rezasede/AURIX_MotorControl_TB_HW/KicadPower/MotorDrive_Power.csv

Reference | Value | Footprint
R10 | Res SMD | RESC1608X55N
R9 | Res SMD | RESC1608X55N
R8 | Res SMD | RESC1608X55N
R7 | Res SMD | RESC1608X55N
R6 | Res SMD | RESC1608X55N
R5 | Res SMD | RESC1608X55N
R4 | Res SMD | RESC1608X55N
R3 | Res SMD | RESC1608X55N
Q8 | IGB110S101 | IFX-PG-VSON-4-3-V
Q7 | IGB110S101 | IFX-PG-VSON-4-3-V
Q6 | IGB110S101 | IFX-PG-VSON-4-3-V
Q5 | IGB110S101 | IFX-PG-VSON-4-3-V
Q4 | IGB110S101 | IFX-PG-VSON-4-3-V
Q3 | IGB110S101 | IFX-PG-VSON-4-3-V
Q2 | IGB110S101 | IFX-PG-VSON-4-3-V
Q1 | IGB110S101 | IFX-PG-VSON-4-3-V
C56 | Cap SMD | CAPC3225X220N
C55 | Cap SMD | CAPC3225X220N
C54 | Cap SMD | CAPC3225X220N
C53 | Cap SMD | CAPC3225X220N
C52 | Cap SMD | CAPC3225X220N
C51 | Cap SMD | CAPC3225X220N
C50 | Cap SMD | CAPC3225X220N
C49 | Cap SMD | CAPC3225X220N
C48 | Cap SMD | CAPC3225X220N
C47 | Cap SMD | CAPC3216X100N
C46 | Cap SMD | CAPC3216X100N
C45 | Cap SMD | CAPC3216X100N
C44 | Cap SMD | CAPC3216X100N
C43 | Cap SMD | CAPC3216X100N
C42 | Cap SMD | CAPC3216X100N
C41 | Cap SMD | CAPC3216X100N
C40 | Cap SMD | CAPC3216X100N
C39 | Cap SMD | CAPC3216X100N
C38 | Cap SMD | CAPC3216X100N
C37 | Cap SMD | CAPC3216X100N
C36 | Cap SMD | CAPC3216X100N
C35 | Cap SMD | CAPC3216X100N
C34 | Cap SMD | CAPC3216X100N
C33 | Cap SMD | CAPC3225X220N
C32 | Cap SMD | CAPC3225X220N
C31 | Cap SMD | CAPC3225X220N
C30 | Cap SMD | CAPC3225X220N
C29 | Cap SMD | CAPC3225X220N
C28 | Cap SMD | CAPC3225X220N
C27 | Cap SMD | CAPC3225X220N
C26 | Cap SMD | CAPC3225X220N
C25 | Cap SMD | CAPC3225X220N
C24 | Cap SMD | CAPC3216X100N
C23 | Cap SMD | CAPC3216X100N
C22 | Cap SMD | CAPC3216X100N
C21 | Cap SMD | CAPC3216X100N
C20 | Cap SMD | CAPC3216X100N
C19 | Cap SMD | CAPC3216X100N
C18 | Cap SMD | CAPC3216X100N
C17 | Cap SMD | CAPC3216X100N
C16 | Cap SMD | CAPC3216X100N
C15 | Cap SMD | CAPC3216X100N
C14 | Cap SMD | CAPC3216X100N
C13 | Cap SMD | CAPC3216X100N
C12 | Cap SMD | CAPC3216X100N
C11 | Cap SMD | CAPC3216X100N
C10 | Cap Pol | CAP-6.3-7.7
C9 | Cap Pol | CAP-6.3-7.7
C8 | Cap SMD | CAPC1608X90N
C7 | Cap SMD | CAPC1608X90N
C6 | Cap SMD | CAPC1608X90N
C5 | Cap SMD | CAPC1608X90N
C4 | Cap SMD | CAPC1608X90N
C3 | Cap SMD | CAPC1608X90N
C2 | Cap SMD | CAPC1608X90N
C1 | Cap SMD | CAPC1608X90N
