rezasede/AURIX_MotorControl_TB_HW/KicadPower/MotorDrive_Power.kicad_pcb

## KiCad design KicadPower/MotorDrive_Power.kicad_pcb (2026-10-25)

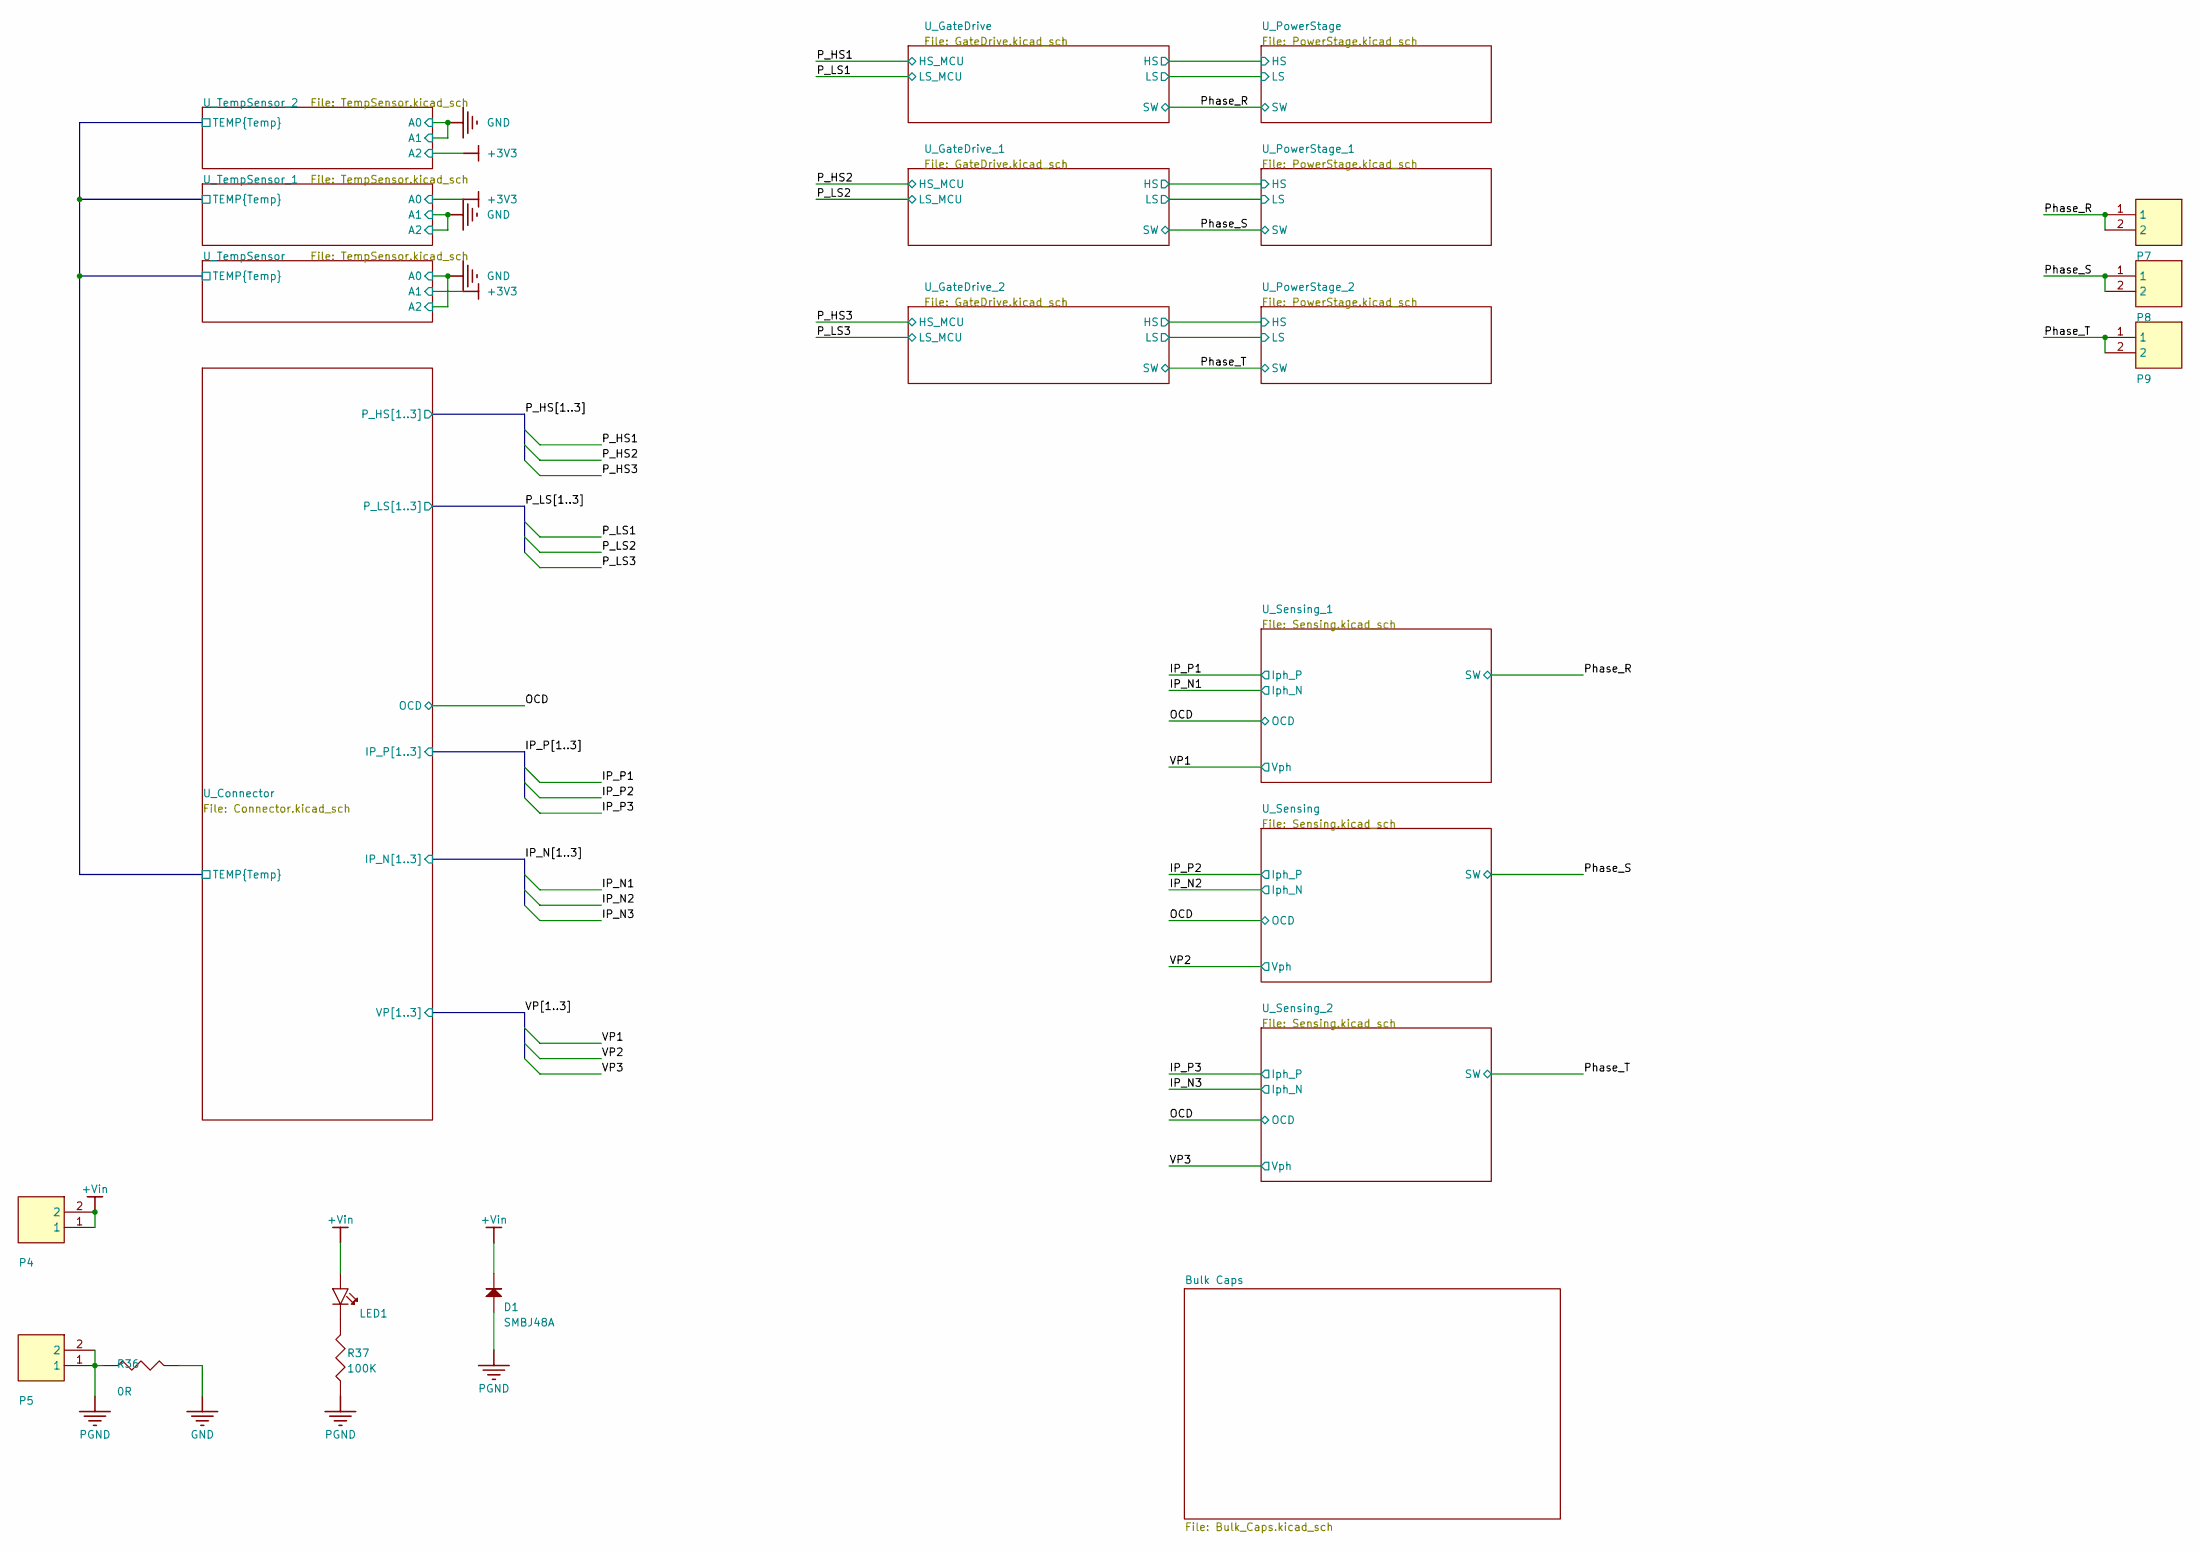
[picture p1: schematic MotorDrive_Power.kicad_sch]

Parts:
D1: SMBJ48A; DO-214AA
LED1: LED; LED0603
P4, P5, P7, P8, P9: Connector; Terminal Block 2pin
R36: Res SMD; RESC3225X70N
R37: Res SMD; RESC1608X55N

Connections:
+Vin: D1.K (2), LED1.1 (A), P4.1, P4.2; also elsewhere on the board
/Phase_R: P7.1, P7.2; also elsewhere on the board
/Phase_S: P8.1, P8.2; also elsewhere on the board
/Phase_T: P9.1, P9.2; also elsewhere on the board
GND: R36.2; also elsewhere on the board
unnamed: LED1.2 (K), R37.2
PGND: D1.A (1), P5.1, P5.2, R36.1, R37.1; also elsewhere on the board

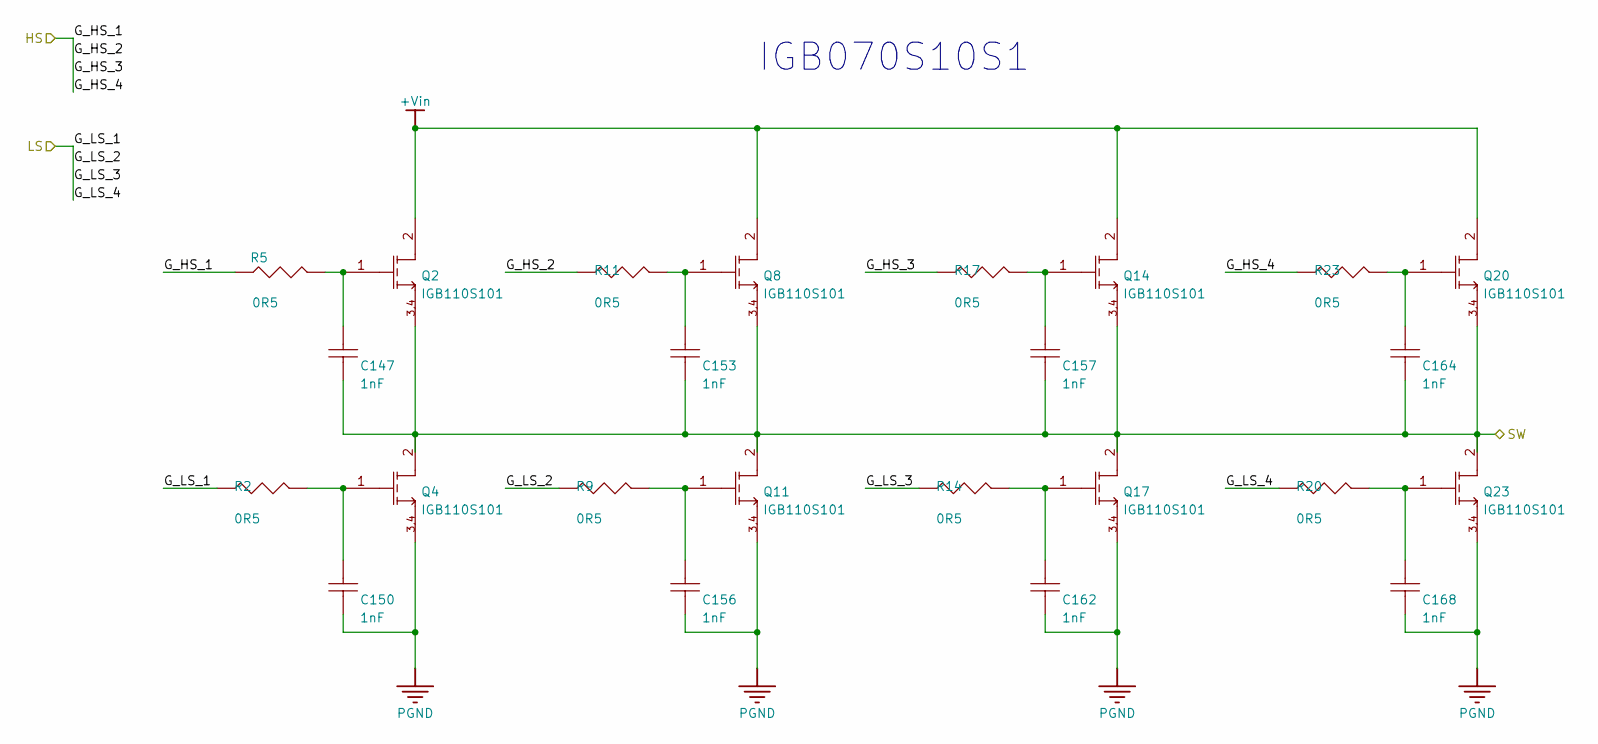
[picture p2: schematic PowerStage.kicad_sch]

Parts:
C147, C150, C153, C156, C157, C162, C164, C168: Cap SMD; CAPC1608X90N
Q2, Q4, Q8, Q11, Q14, Q17, Q20, Q23: IGB110S101; IFX-PG-VSON-4-3-V
R2, R5, R9, R11, R14, R17, R20, R23: Res SMD; RESC1608X55N

Connections:
+Vin: Q2.2 (D), Q8.2 (D), Q14.2 (D), Q20.2 (D); also elsewhere on the board
/Phase_R: C147.1, C153.1, C157.1, C164.1, Q2.3 (S1), Q2.4 (S2), Q4.2 (D), Q8.3 (S1), Q8.4 (S2), Q11.2 (D), Q14.3 (S1), Q14.4 (S2), Q17.2 (D), Q20.3 (S1), Q20.4 (S2), Q23.2 (D); also elsewhere on the board
/U_PowerStage/G_HS_1: R5.1, R11.1, R17.1, R23.1; also elsewhere on the board
/U_PowerStage/G_LS_1: R2.1, R9.1, R14.1, R20.1; also elsewhere on the board
unnamed: C147.2, Q2.1 (G), R5.2
unnamed: C150.2, Q4.1 (G), R2.2
unnamed: C153.2, Q8.1 (G), R11.2
unnamed: C156.2, Q11.1 (G), R9.2
unnamed: C157.2, Q14.1 (G), R17.2
unnamed: C162.2, Q17.1 (G), R14.2
unnamed: C164.2, Q20.1 (G), R23.2
unnamed: C168.2, Q23.1 (G), R20.2
PGND: C150.1, C156.1, C162.1, C168.1, Q4.3 (S1), Q4.4 (S2), Q11.3 (S1), Q11.4 (S2), Q17.3 (S1), Q17.4 (S2), Q23.3 (S1), Q23.4 (S2); also elsewhere on the board

Parts of its further copies:
C145, C146, C148, C149, C151, C152, C154, C155, C158, C159, C160, C161, C163, C165, C166, C167: Cap SMD; CAPC1608X90N
Q1, Q3, Q5, Q6, Q7, Q9, Q10, Q12, Q13, Q15, Q16, Q18, Q19, Q21, Q22, Q24: IGB110S101; IFX-PG-VSON-4-3-V
R1, R3, R4, R6, R7, R8, R10, R12, R13, R15, R16, R18, R19, R21, R22, R24: Res SMD; RESC1608X55N

Connections of its further copies:
+Vin: Q1.2 (D), Q3.2 (D), Q7.2 (D), Q9.2 (D), Q13.2 (D), Q15.2 (D), Q19.2 (D), Q21.2 (D); also elsewhere on the board
/Phase_S: C145.1, C152.1, C159.1, C163.1, Q1.3 (S1), Q1.4 (S2), Q5.2 (D), Q7.3 (S1), Q7.4 (S2), Q10.2 (D), Q13.3 (S1), Q13.4 (S2), Q18.2 (D), Q21.3 (S1), Q21.4 (S2), Q24.2 (D); also elsewhere on the board
/Phase_T: C146.1, C151.1, C158.1, C165.1, Q3.3 (S1), Q3.4 (S2), Q6.2 (D), Q9.3 (S1), Q9.4 (S2), Q12.2 (D), Q15.3 (S1), Q15.4 (S2), Q16.2 (D), Q19.3 (S1), Q19.4 (S2), Q22.2 (D); also elsewhere on the board
/U_PowerStage_1/G_HS_1: R4.1, R10.1, R18.1, R22.1; also elsewhere on the board
/U_PowerStage_1/G_LS_1: R1.1, R7.1, R15.1, R19.1; also elsewhere on the board
/U_PowerStage_2/G_HS_1: R6.1, R12.1, R16.1, R24.1; also elsewhere on the board
/U_PowerStage_2/G_LS_1: R3.1, R8.1, R13.1, R21.1; also elsewhere on the board
unnamed: C145.2, Q1.1 (G), R4.2
unnamed: C146.2, Q3.1 (G), R6.2
unnamed: C149.2, Q5.1 (G), R1.2
unnamed: C148.2, Q6.1 (G), R3.2
unnamed: C152.2, Q7.1 (G), R10.2
unnamed: C151.2, Q9.1 (G), R12.2
unnamed: C155.2, Q10.1 (G), R7.2
unnamed: C154.2, Q12.1 (G), R8.2
unnamed: C159.2, Q13.1 (G), R18.2
unnamed: C158.2, Q15.1 (G), R16.2
unnamed: C161.2, Q16.1 (G), R13.2
unnamed: C160.2, Q18.1 (G), R15.2
unnamed: C165.2, Q19.1 (G), R24.2
unnamed: C163.2, Q21.1 (G), R22.2
unnamed: C167.2, Q22.1 (G), R21.2
unnamed: C166.2, Q24.1 (G), R19.2
PGND: C148.1, C149.1, C154.1, C155.1, C160.1, C161.1, C166.1, C167.1, Q5.3 (S1), Q5.4 (S2), Q6.3 (S1), Q6.4 (S2), Q10.3 (S1), Q10.4 (S2), Q12.3 (S1), Q12.4 (S2), Q16.3 (S1), Q16.4 (S2), Q18.3 (S1), Q18.4 (S2), Q22.3 (S1), Q22.4 (S2), Q24.3 (S1), Q24.4 (S2); also elsewhere on the board

Notes on the sheet:
IGB070S10S1

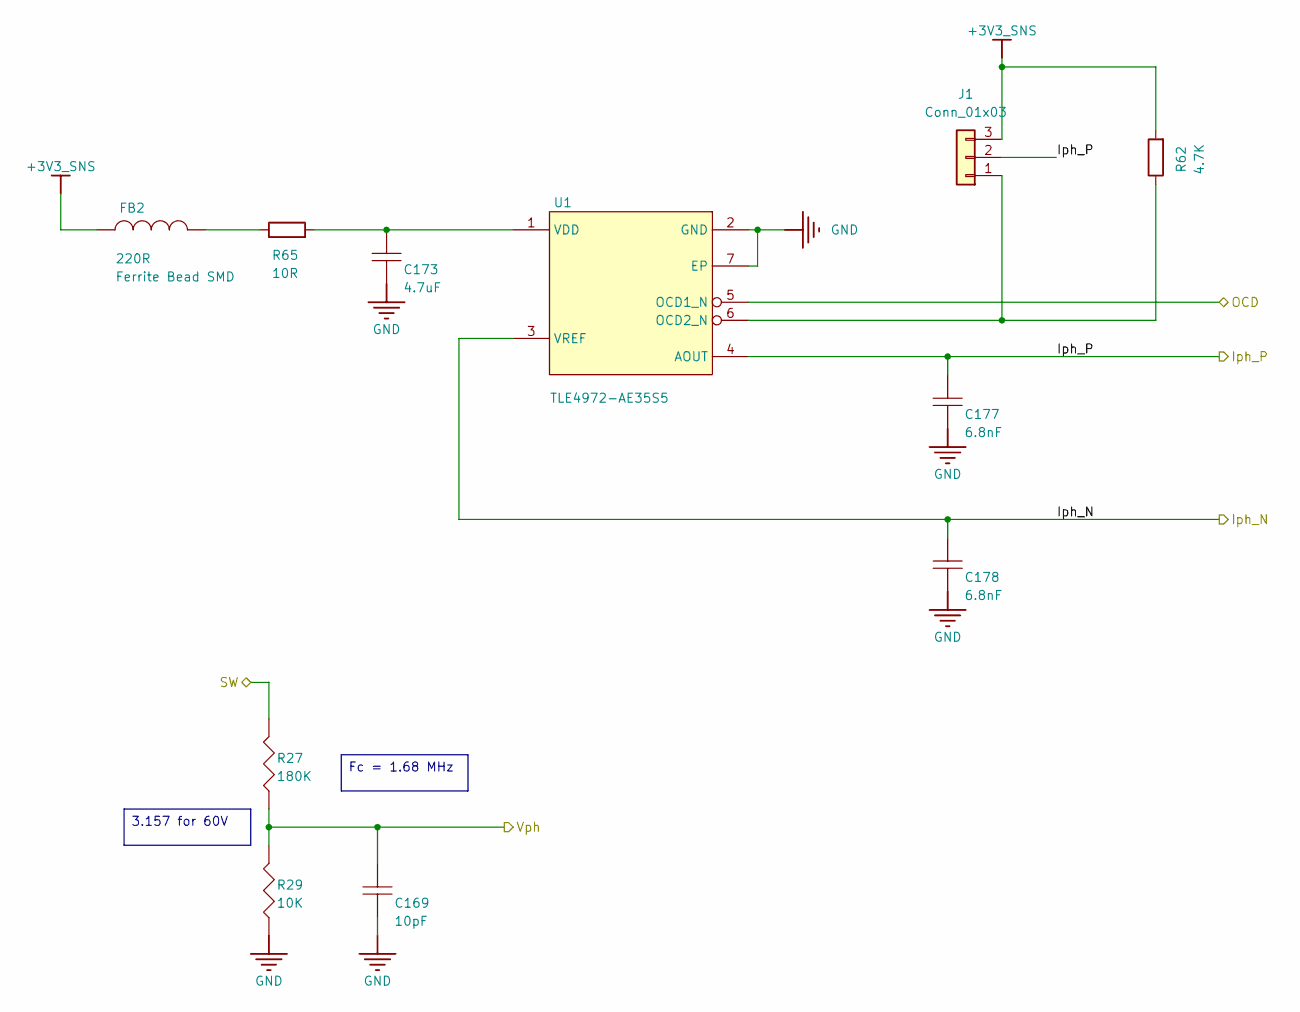
[picture p3: schematic Sensing.kicad_sch]

Parts:
C169, C177, C178: Cap SMD; CAPC1608X90N
C173: Cap SMD; CAPC2012X135N
FB2: Ferrite Bead SMD; RESC2012X70N
J1: Conn_01x03; PinHeader_1x03_P2.54mm_Vertical
R27, R29: Res SMD; RESC1608X55N
R62: 4.7K; R_0603_1608Metric_Pad0.98x0.95mm_HandSolder
R65: 10R; R_0603_1608Metric_Pad0.98x0.95mm_HandSolder
U1: TLE4972-AE35S5; IFX-PG-VSON-6-V

Connections:
+3V3_SNS: FB2.1, J1.3, R62.2; also elsewhere on the board
/IP_N1: C178.2, U1.3 (VREF); also elsewhere on the board
/IP_P1: C177.2, J1.2, U1.4 (AOUT); also elsewhere on the board
/OCD: U1.5 (OCD1_N); also elsewhere on the board
/Phase_R: R27.2; also elsewhere on the board
/VP1: C169.2, R27.1, R29.2; also elsewhere on the board
GND: C169.1, C173.1, C177.1, C178.1, R29.1, U1.2 (GND), U1.7 (EP); also elsewhere on the board
unnamed: FB2.2, R65.1
unnamed: J1.1, R62.1, U1.6 (OCD2_N)
unnamed: C173.2, R65.2, U1.1 (VDD)

Parts of its further copies:
C170, C171, C175, C176, C179, C180: Cap SMD; CAPC1608X90N
C172, C174: Cap SMD; CAPC2012X135N
FB1, FB3: Ferrite Bead SMD; RESC2012X70N
J2, J3: Conn_01x03; PinHeader_1x03_P2.54mm_Vertical
R25, R26, R28, R30: Res SMD; RESC1608X55N
R63, R64: 4.7K; R_0603_1608Metric_Pad0.98x0.95mm_HandSolder
R66, R67: 10R; R_0603_1608Metric_Pad0.98x0.95mm_HandSolder
U2, U3: TLE4972-AE35S5; IFX-PG-VSON-6-V

Connections of its further copies:
+3V3_SNS: FB1.1, FB3.1, J2.3, J3.3, R63.2, R64.2; also elsewhere on the board
/IP_N2: C179.2, U2.3 (VREF); also elsewhere on the board
/IP_N3: C180.2, U3.3 (VREF); also elsewhere on the board
/IP_P2: C176.2, J2.2, U2.4 (AOUT); also elsewhere on the board
/IP_P3: C175.2, J3.2, U3.4 (AOUT); also elsewhere on the board
/OCD: U2.5 (OCD1_N), U3.5 (OCD1_N); also elsewhere on the board
/Phase_S: R25.2; also elsewhere on the board
/Phase_T: R26.2; also elsewhere on the board
/VP2: C170.2, R25.1, R30.2; also elsewhere on the board
/VP3: C171.2, R26.1, R28.2; also elsewhere on the board
GND: C170.1, C171.1, C172.1, C174.1, C175.1, C176.1, C179.1, C180.1, R28.1, R30.1, U2.2 (GND), U2.7 (EP), U3.2 (GND), U3.7 (EP); also elsewhere on the board
unnamed: FB1.2, R67.1
unnamed: FB3.2, R66.1
unnamed: J2.1, R63.1, U2.6 (OCD2_N)
unnamed: J3.1, R64.1, U3.6 (OCD2_N)
unnamed: C174.2, R66.2, U2.1 (VDD)
unnamed: C172.2, R67.2, U3.1 (VDD)

Notes on the sheet:
Fc = 1.68 MHz
3.157 for 60V

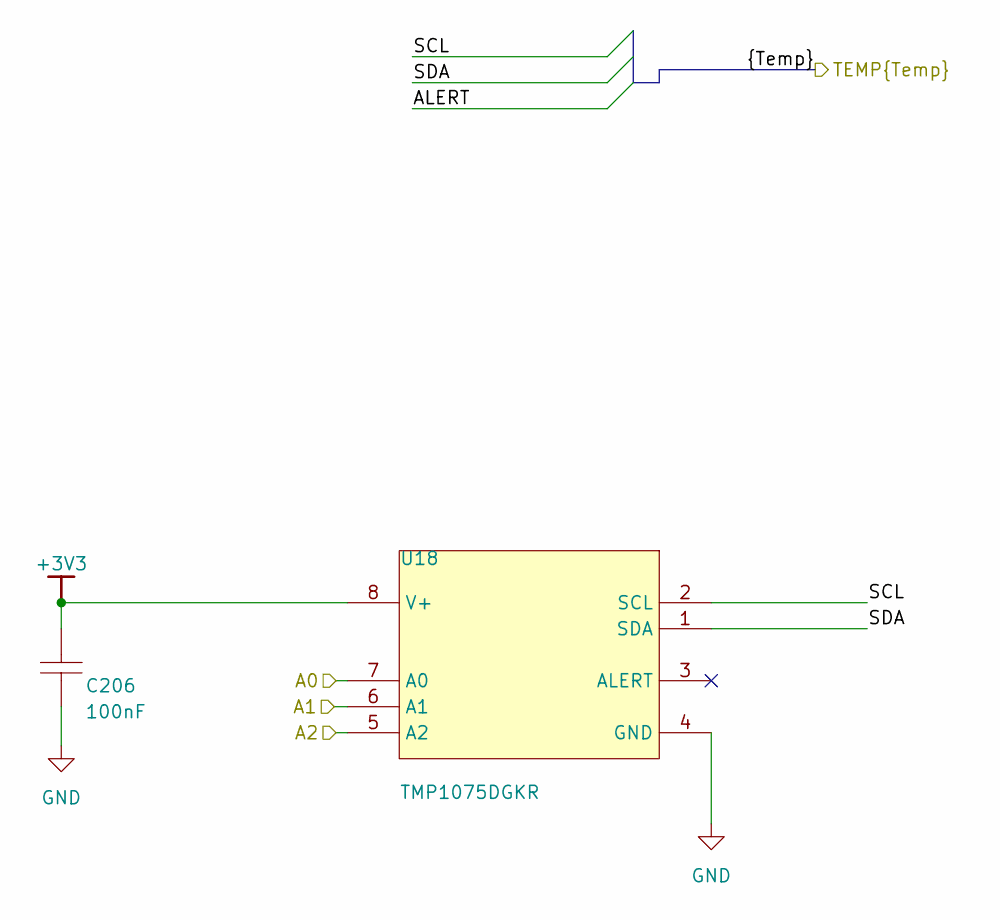
[picture p4: schematic TempSensor.kicad_sch]

Parts:
C206: Cap SMD; CAPC1608X90N
U18: TMP1075DGKR; DGK0008A_N; MANUFACTURER_PART_NUMBER TMP1075DGKR

Connections:
+3V3: C206.2, U18.5 (A2), U18.8 (V+); also elsewhere on the board
/U_Connector/SCL: U18.2 (SCL); also elsewhere on the board
/U_Connector/SDA: U18.1 (SDA); also elsewhere on the board
GND: C206.1, U18.4 (GND), U18.6 (A1), U18.7 (A0); also elsewhere on the board

Parts of its further copies:
C207, C208: Cap SMD; CAPC1608X90N
U17, U19: TMP1075DGKR; DGK0008A_N; MANUFACTURER_PART_NUMBER TMP1075DGKR

Connections of its further copies:
+3V3: C207.2, C208.2, U17.7 (A0), U17.8 (V+), U19.6 (A1), U19.8 (V+); also elsewhere on the board
/U_Connector/SCL: U17.2 (SCL), U19.2 (SCL); also elsewhere on the board
/U_Connector/SDA: U17.1 (SDA), U19.1 (SDA); also elsewhere on the board
GND: C207.1, C208.1, U17.4 (GND), U17.5 (A2), U17.6 (A1), U19.4 (GND), U19.5 (A2), U19.7 (A0); also elsewhere on the board

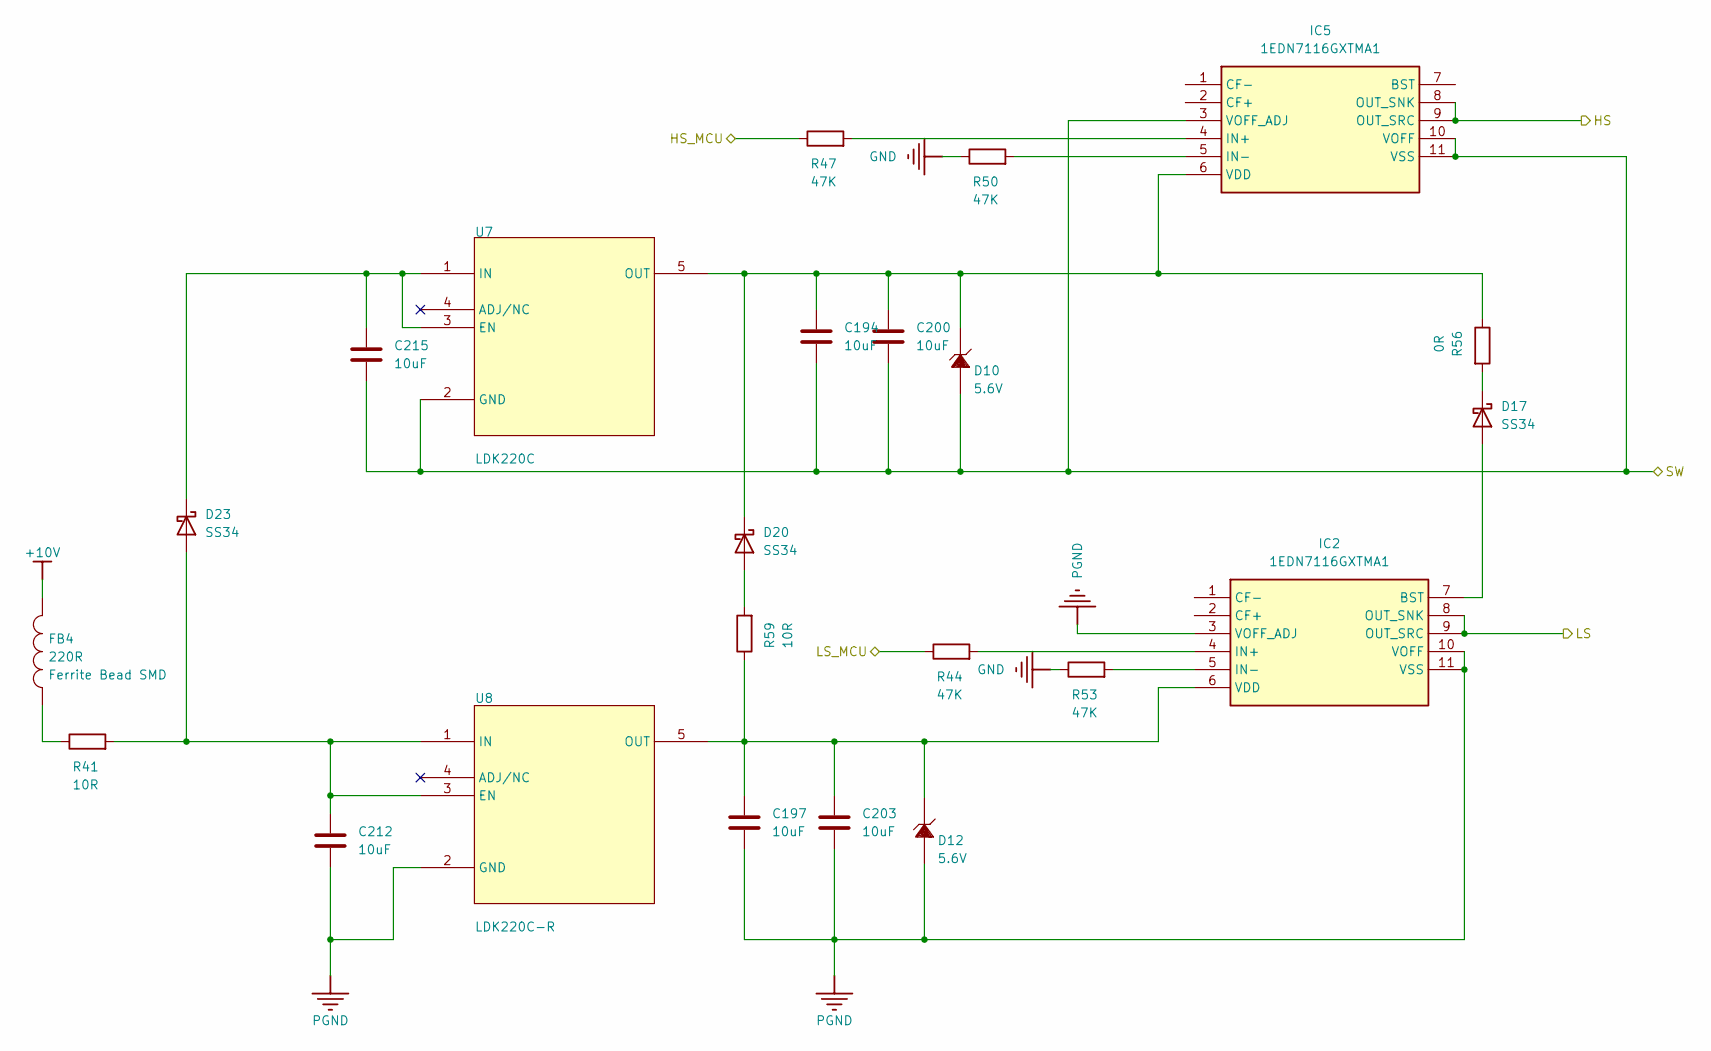
[picture p5: schematic GateDrive.kicad_sch]

Parts:
C194, C197, C200, C203, C212, C215: 10uF; C_0603_1608Metric
D10, D12: 5.6V; DIOMELF3615N
D17, D20, D23: SS34; D_SMA
FB4: Ferrite Bead SMD; RESC2012X70N
IC2, IC5: 1EDN7116GXTMA1; Manufacturer_Part_Number 1EDN7116GXTMA1; Mouser Part Number 726-1EDN7116GXTMA1
R41, R59: 10R; R_0603_1608Metric_Pad0.98x0.95mm_HandSolder
R44, R47, R50, R53: 47K; R_0603_1608Metric_Pad0.98x0.95mm_HandSolder
R56: 0R; R_0603_1608Metric_Pad0.98x0.95mm_HandSolder
U7: LDK220C; SOT_220M-R_STM; MANUFACTURER_PART_NUMBER LDK220C-R
U8: LDK220C-R; SOT_220M-R_STM; MANUFACTURER_PART_NUMBER LDK220C-R

Connections:
+10V: FB4.2; also elsewhere on the board
/P_HS1: R47.1; also elsewhere on the board
/P_LS1: R44.1; also elsewhere on the board
/Phase_R: C194.2, C200.2, C215.2, D10.2, IC5.3 (VOFF_ADJ), IC5.10 (VOFF), IC5.11 (VSS), U7.2 (GND); also elsewhere on the board
/U_PowerStage/G_HS_1: IC5.8 (OUT_SNK), IC5.9 (OUT_SRC); also elsewhere on the board
/U_PowerStage/G_LS_1: IC2.8 (OUT_SNK), IC2.9 (OUT_SRC); also elsewhere on the board
GND: R50.1, R53.1; also elsewhere on the board
unnamed: D17.2 (A), IC2.7 (BST)
unnamed: D17.1 (K), R56.2
unnamed: D20.2 (A), R59.2
unnamed: C194.1, C200.1, D10.1, D20.1 (K), IC5.6 (VDD), R56.1, U7.5 (OUT)
unnamed: C212.1, D23.2 (A), R41.2, U8.1 (IN), U8.3 (EN)
unnamed: C215.1, D23.1 (K), U7.1 (IN), U7.3 (EN)
unnamed: FB4.1, R41.1
unnamed: IC2.4 (IN+), R44.2
unnamed: IC2.5 (IN-), R53.2
unnamed: C197.1, C203.1, D12.1, IC2.6 (VDD), R59.1, U8.5 (OUT)
unnamed: IC5.4 (IN+), R47.2
unnamed: IC5.5 (IN-), R50.2
PGND: C197.2, C203.2, C212.2, D12.2, IC2.3 (VOFF_ADJ), IC2.10 (VOFF), IC2.11 (VSS), U8.2 (GND); also elsewhere on the board

Parts of its further copies:
C195, C196, C198, C199, C201, C202, C204, C205, C213, C214, C216, C217: 10uF; C_0603_1608Metric
D8, D9, D11, D13: 5.6V; DIOMELF3615N
D18, D19, D21, D22, D24, D25: SS34; D_SMA
FB5, FB6: Ferrite Bead SMD; RESC2012X70N
IC3, IC4, IC6, IC7: 1EDN7116GXTMA1; Manufacturer_Part_Number 1EDN7116GXTMA1; Mouser Part Number 726-1EDN7116GXTMA1
R42, R43, R60, R61: 10R; R_0603_1608Metric_Pad0.98x0.95mm_HandSolder
R45, R46, R48, R49, R51, R52, R54, R55: 47K; R_0603_1608Metric_Pad0.98x0.95mm_HandSolder
R57, R58: 0R; R_0603_1608Metric_Pad0.98x0.95mm_HandSolder
U5, U6: LDK220C; SOT_220M-R_STM; MANUFACTURER_PART_NUMBER LDK220C-R
U9, U10: LDK220C-R; SOT_220M-R_STM; MANUFACTURER_PART_NUMBER LDK220C-R

Connections of its further copies:
+10V: FB5.2, FB6.2; also elsewhere on the board
/P_HS2: R48.1; also elsewhere on the board
/P_HS3: R49.1; also elsewhere on the board
/P_LS2: R45.1; also elsewhere on the board
/P_LS3: R46.1; also elsewhere on the board
/Phase_S: C195.2, C201.2, C216.2, D9.2, IC6.3 (VOFF_ADJ), IC6.10 (VOFF), IC6.11 (VSS), U6.2 (GND); also elsewhere on the board
/Phase_T: C196.2, C202.2, C217.2, D8.2, IC7.3 (VOFF_ADJ), IC7.10 (VOFF), IC7.11 (VSS), U5.2 (GND); also elsewhere on the board
/U_PowerStage_1/G_HS_1: IC6.8 (OUT_SNK), IC6.9 (OUT_SRC); also elsewhere on the board
/U_PowerStage_1/G_LS_1: IC3.8 (OUT_SNK), IC3.9 (OUT_SRC); also elsewhere on the board
/U_PowerStage_2/G_HS_1: IC7.8 (OUT_SNK), IC7.9 (OUT_SRC); also elsewhere on the board
/U_PowerStage_2/G_LS_1: IC4.8 (OUT_SNK), IC4.9 (OUT_SRC); also elsewhere on the board
GND: R51.1, R52.1, R54.1, R55.1; also elsewhere on the board
unnamed: D18.2 (A), IC3.7 (BST)
unnamed: D18.1 (K), R57.2
unnamed: D19.2 (A), IC4.7 (BST)
unnamed: D19.1 (K), R58.2
unnamed: D21.2 (A), R60.2
unnamed: C195.1, C201.1, D9.1, D21.1 (K), IC6.6 (VDD), R57.1, U6.5 (OUT)
unnamed: D22.2 (A), R61.2
unnamed: C196.1, C202.1, D8.1, D22.1 (K), IC7.6 (VDD), R58.1, U5.5 (OUT)
unnamed: C213.1, D24.2 (A), R42.2, U10.1 (IN), U10.3 (EN)
unnamed: C216.1, D24.1 (K), U6.1 (IN), U6.3 (EN)
unnamed: C214.1, D25.2 (A), R43.2, U9.1 (IN), U9.3 (EN)
unnamed: C217.1, D25.1 (K), U5.1 (IN), U5.3 (EN)
unnamed: FB5.1, R43.1
unnamed: FB6.1, R42.1
unnamed: IC3.4 (IN+), R45.2
unnamed: IC3.5 (IN-), R54.2
unnamed: C198.1, C204.1, D13.1, IC3.6 (VDD), R60.1, U10.5 (OUT)
unnamed: IC4.4 (IN+), R46.2
unnamed: IC4.5 (IN-), R55.2
unnamed: C199.1, C205.1, D11.1, IC4.6 (VDD), R61.1, U9.5 (OUT)
unnamed: IC6.4 (IN+), R48.2
unnamed: IC6.5 (IN-), R51.2
unnamed: IC7.4 (IN+), R49.2
unnamed: IC7.5 (IN-), R52.2
PGND: C198.2, C199.2, C204.2, C205.2, C213.2, C214.2, D11.2, D13.2, IC3.3 (VOFF_ADJ), IC3.10 (VOFF), IC3.11 (VSS), IC4.3 (VOFF_ADJ), IC4.10 (VOFF), IC4.11 (VSS), U9.2 (GND), U10.2 (GND); also elsewhere on the board

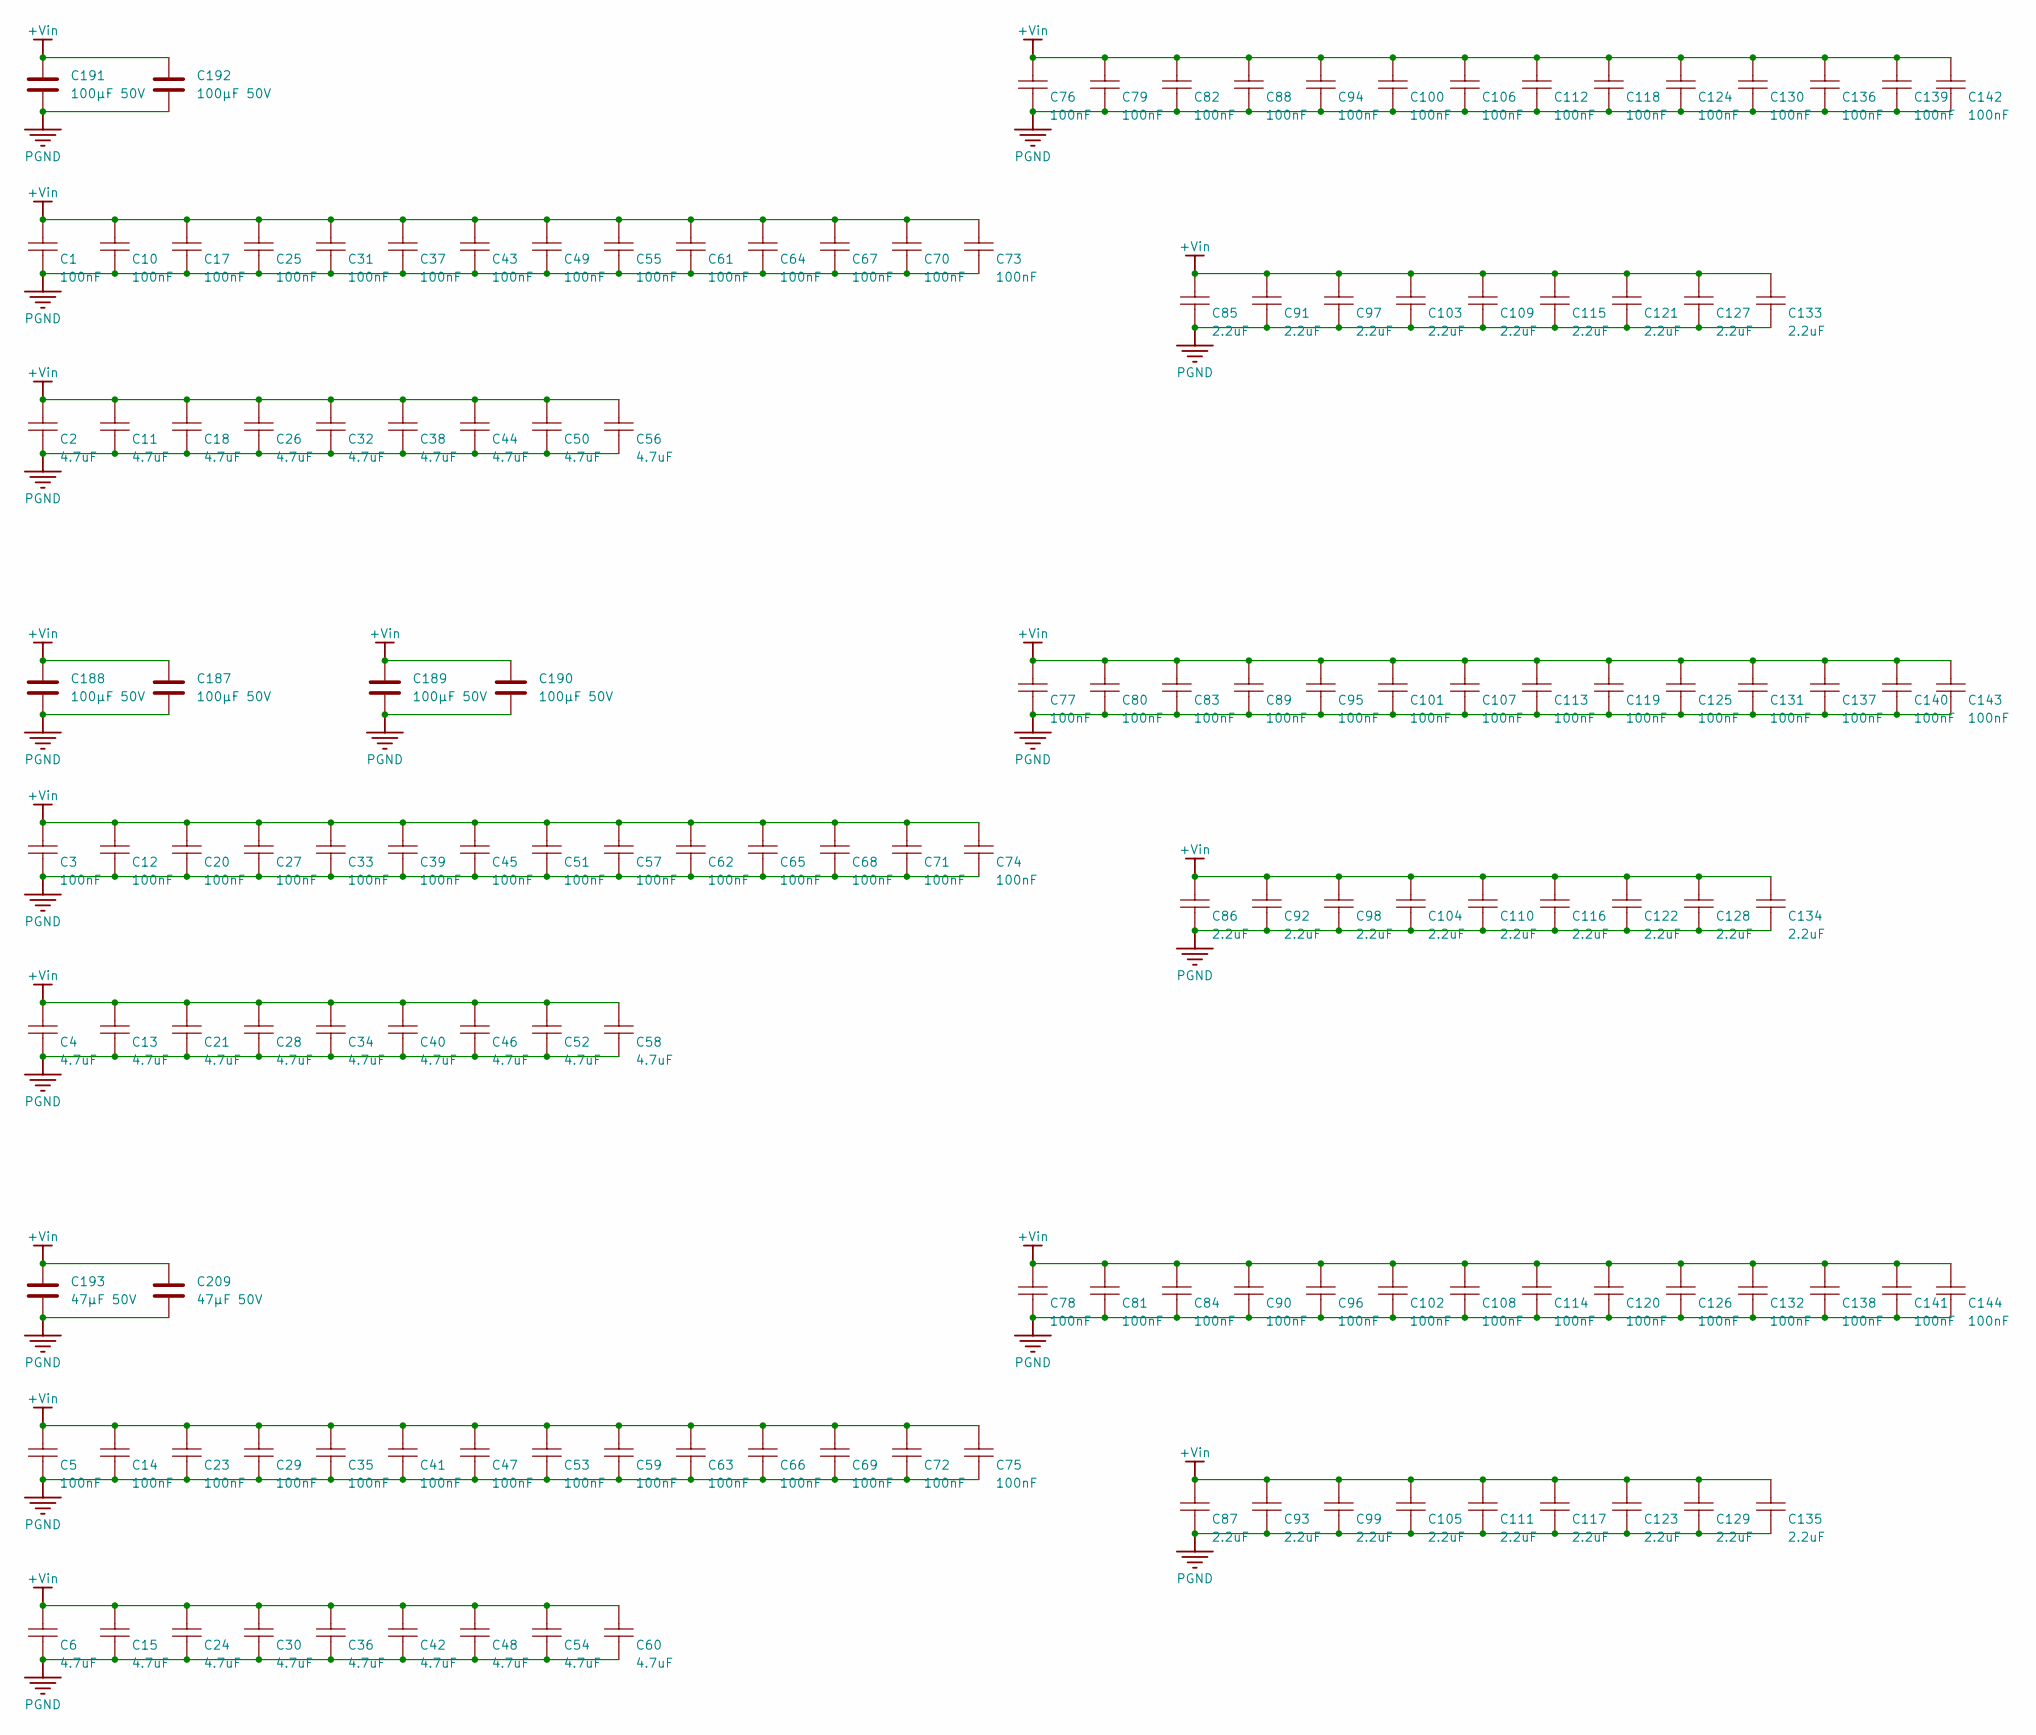
[picture p6: schematic Bulk_Caps.kicad_sch]

Parts:
C1, C3, C5, C10, C12, C14, C17, C20, C23, C25, C27, C29, C31, C33, C35, C37, C39, C41, C43, C45, C47, C49, C51, C53, C55, C57, C59, C61, C62, C63, C64, C65, C66, C67, C68, C69, C70, C71, C72, C73, C74, C75, C76, C77, C78, C79, C80, C81, C82, C83, C84, C88, C89, C90, C94, C95, C96, C100, C101, C102, C106, C107, C108, C112, C113, C114, C118, C119, C120, C124, C125, C126, C130, C131, C132, C136, C137, C138, C139, C140, C141, C142, C143, C144: Cap SMD; CAPC3216X100N
C2, C4, C6, C11, C13, C15, C18, C21, C24, C26, C28, C30, C32, C34, C36, C38, C40, C42, C44, C46, C48, C50, C52, C54, C56, C58, C60, C85, C86, C87, C91, C92, C93, C97, C98, C99, C103, C104, C105, C109, C110, C111, C115, C116, C117, C121, C122, C123, C127, C128, C129, C133, C134, C135: Cap SMD; CAPC3225X220N
C187, C188, C189, C190, C191, C192: 100µF 50V; C_Elec_8x10.2
C193, C209: 47µF 50V; C_Elec_6.3x7.7

Connections:
+Vin: C1.2, C2.2, C3.2, C4.2, C5.2, C6.2, C10.2, C11.2, C12.2, C13.2, C14.2, C15.2, C17.2, C18.2, C20.2, C21.2, C23.2, C24.2, C25.2, C26.2, C27.2, C28.2, C29.2, C30.2, C31.2, C32.2, C33.2, C34.2, C35.2, C36.2, C37.2, C38.2, C39.2, C40.2, C41.2, C42.2, C43.2, C44.2, C45.2, C46.2, C47.2, C48.2, C49.2, C50.2, C51.2, C52.2, C53.2, C54.2, C55.2, C56.2, C57.2, C58.2, C59.2, C60.2, C61.2, C62.2, C63.2, C64.2, C65.2, C66.2, C67.2, C68.2, C69.2, C70.2, C71.2, C72.2, C73.2, C74.2, C75.2, C76.2, C77.2, C78.2, C79.2, C80.2, C81.2, C82.2, C83.2, C84.2, C85.2, C86.2, C87.2, C88.2, C89.2, C90.2, C91.2, C92.2, C93.2, C94.2, C95.2, C96.2, C97.2, C98.2, C99.2, C100.2, C101.2, C102.2, C103.2, C104.2, C105.2, C106.2, C107.2, C108.2, C109.2, C110.2, C111.2, C112.2, C113.2, C114.2, C115.2, C116.2, C117.2, C118.2, C119.2, C120.2, C121.2, C122.2, C123.2, C124.2, C125.2, C126.2, C127.2, C128.2, C129.2, C130.2, C131.2, C132.2, C133.2, C134.2, C135.2, C136.2, C137.2, C138.2, C139.2, C140.2, C141.2, C142.2, C143.2, C144.2, C187.1, C188.1, C189.1, C190.1, C191.1, C192.1, C193.1, C209.1; also elsewhere on the board
PGND: C1.1, C2.1, C3.1, C4.1, C5.1, C6.1, C10.1, C11.1, C12.1, C13.1, C14.1, C15.1, C17.1, C18.1, C20.1, C21.1, C23.1, C24.1, C25.1, C26.1, C27.1, C28.1, C29.1, C30.1, C31.1, C32.1, C33.1, C34.1, C35.1, C36.1, C37.1, C38.1, C39.1, C40.1, C41.1, C42.1, C43.1, C44.1, C45.1, C46.1, C47.1, C48.1, C49.1, C50.1, C51.1, C52.1, C53.1, C54.1, C55.1, C56.1, C57.1, C58.1, C59.1, C60.1, C61.1, C62.1, C63.1, C64.1, C65.1, C66.1, C67.1, C68.1, C69.1, C70.1, C71.1, C72.1, C73.1, C74.1, C75.1, C76.1, C77.1, C78.1, C79.1, C80.1, C81.1, C82.1, C83.1, C84.1, C85.1, C86.1, C87.1, C88.1, C89.1, C90.1, C91.1, C92.1, C93.1, C94.1, C95.1, C96.1, C97.1, C98.1, C99.1, C100.1, C101.1, C102.1, C103.1, C104.1, C105.1, C106.1, C107.1, C108.1, C109.1, C110.1, C111.1, C112.1, C113.1, C114.1, C115.1, C116.1, C117.1, C118.1, C119.1, C120.1, C121.1, C122.1, C123.1, C124.1, C125.1, C126.1, C127.1, C128.1, C129.1, C130.1, C131.1, C132.1, C133.1, C134.1, C135.1, C136.1, C137.1, C138.1, C139.1, C140.1, C141.1, C142.1, C143.1, C144.1, C187.2, C188.2, C189.2, C190.2, C191.2, C192.2, C193.2, C209.2; also elsewhere on the board
