rezasede/AURIX_MotorControl_TB_HW/KicadPower/MotorDrive_Power.kicad_pcb

## KiCad design KicadPower/MotorDrive_Power.kicad_pcb (continued)

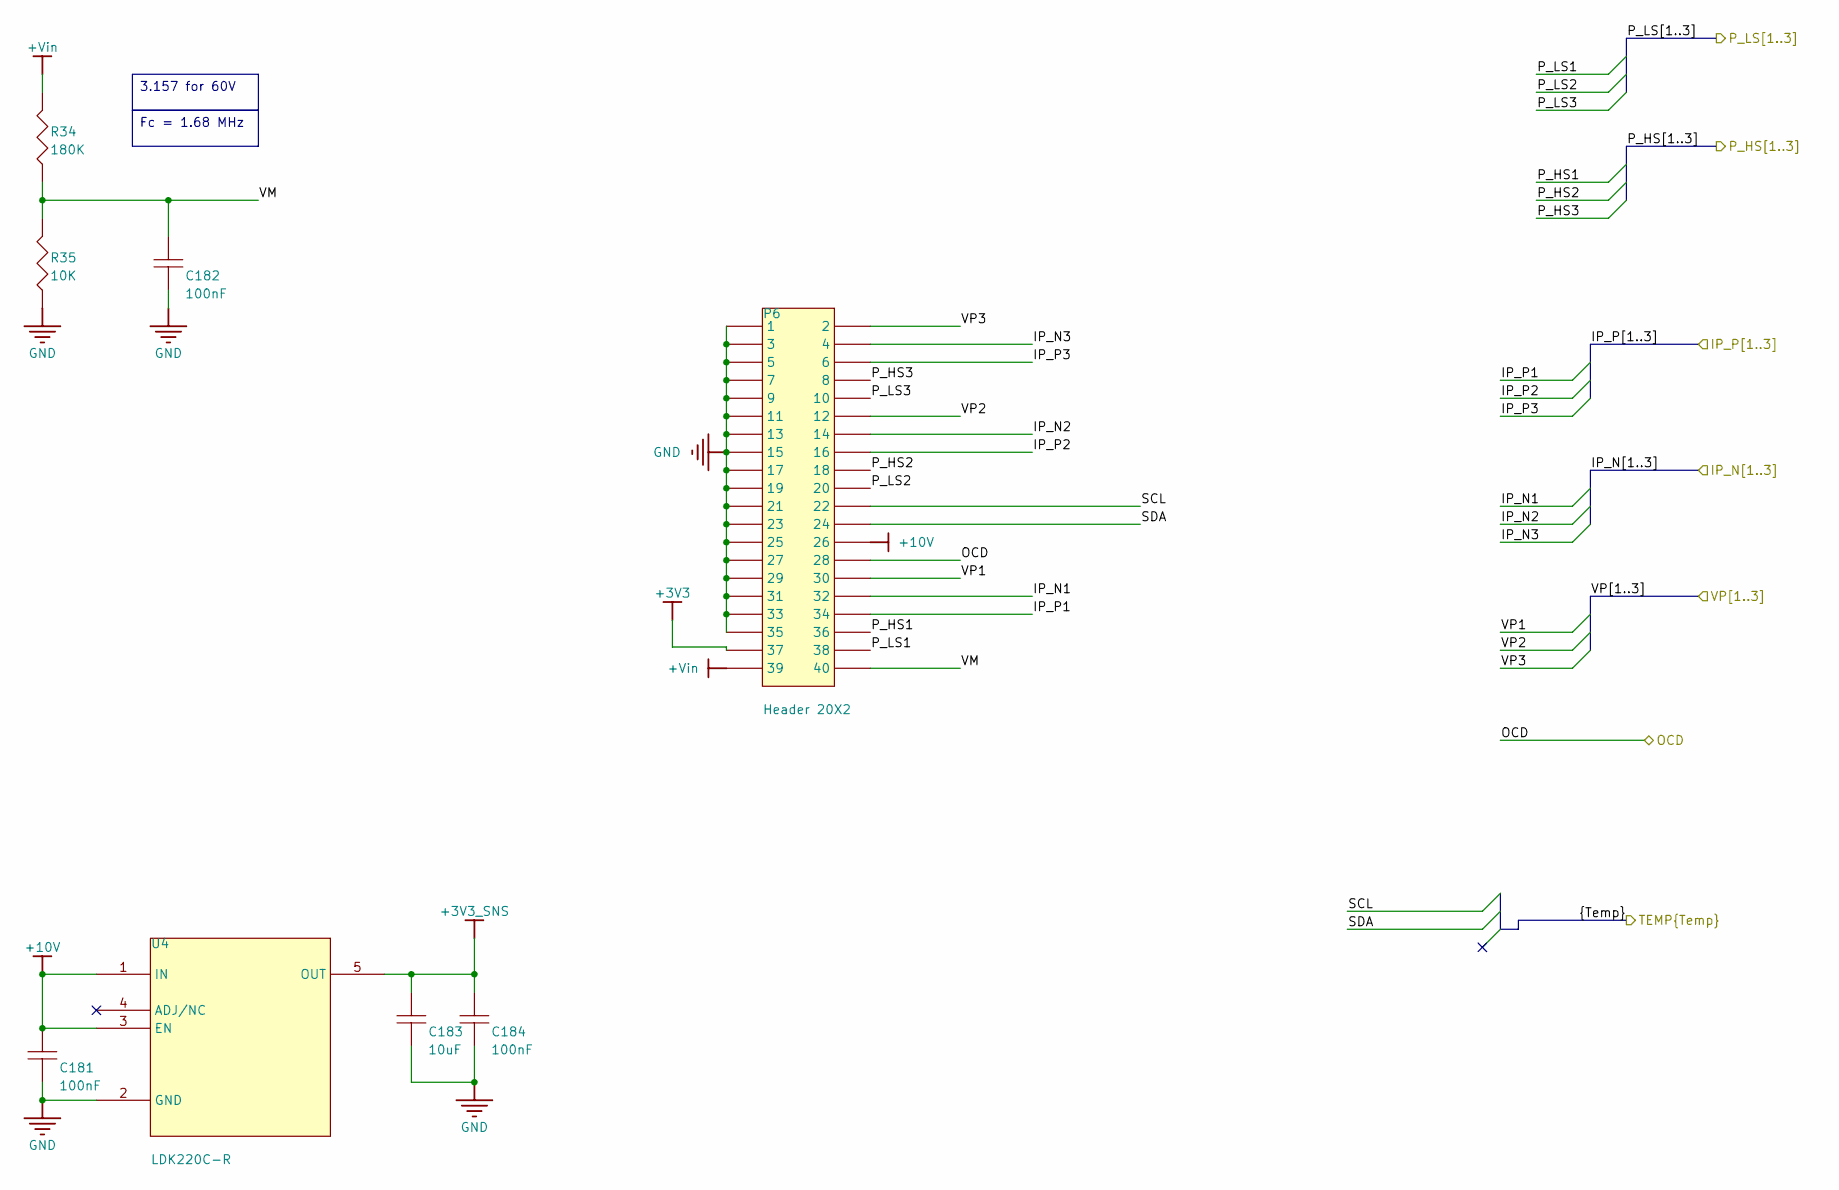
[picture p7: schematic Connector.kicad_sch]

Parts:
C181, C182, C183, C184: Cap SMD; CAPC1608X90N
P6: Header 20X2; HDR2X20-MD
R34, R35: Res SMD; RESC1608X55N
U4: LDK220C-R; SOT_220M-R_STM; MANUFACTURER_PART_NUMBER LDK220C-R

Connections:
+3V3: P6.37; also elsewhere on the board
+3V3_SNS: C183.2, C184.2, U4.5 (OUT); also elsewhere on the board
+10V: C181.2, P6.26, U4.1 (IN), U4.3 (EN); also elsewhere on the board
+Vin: P6.39, R34.2; also elsewhere on the board
/IP_N1: P6.32; also elsewhere on the board
/IP_N2: P6.14; also elsewhere on the board
/IP_N3: P6.4; also elsewhere on the board
/IP_P1: P6.34; also elsewhere on the board
/IP_P2: P6.16; also elsewhere on the board
/IP_P3: P6.6; also elsewhere on the board
/OCD: P6.28; also elsewhere on the board
/P_HS1: P6.36; also elsewhere on the board
/P_HS2: P6.18; also elsewhere on the board
/P_HS3: P6.8; also elsewhere on the board
/P_LS1: P6.38; also elsewhere on the board
/P_LS2: P6.20; also elsewhere on the board
/P_LS3: P6.10; also elsewhere on the board
/U_Connector/SCL: P6.22; also elsewhere on the board
/U_Connector/SDA: P6.24; also elsewhere on the board
/U_Connector/VM: C182.2, P6.40, R34.1, R35.2
/VP1: P6.30; also elsewhere on the board
/VP2: P6.12; also elsewhere on the board
/VP3: P6.2; also elsewhere on the board
GND: C181.1, C182.1, C183.1, C184.1, P6.1, P6.3, P6.5, P6.7, P6.9, P6.11, P6.13, P6.15, P6.17, P6.19, P6.21, P6.23, P6.25, P6.27, P6.29, P6.31, P6.33, P6.35, R35.1, U4.2 (GND); also elsewhere on the board

Notes on the sheet:
3.157 for 60V
Fc = 1.68 MHz

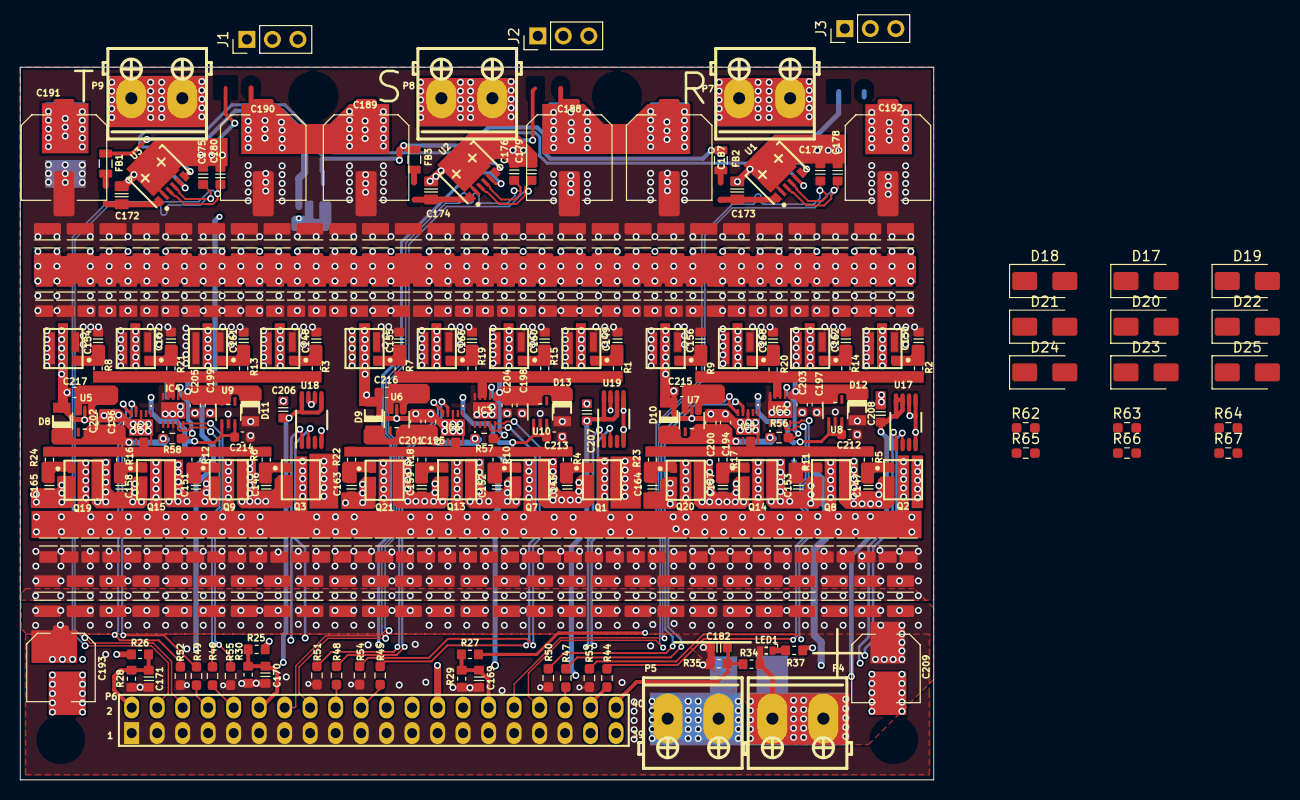
[picture p8: board MotorDrive_Power.kicad_pcb from above]

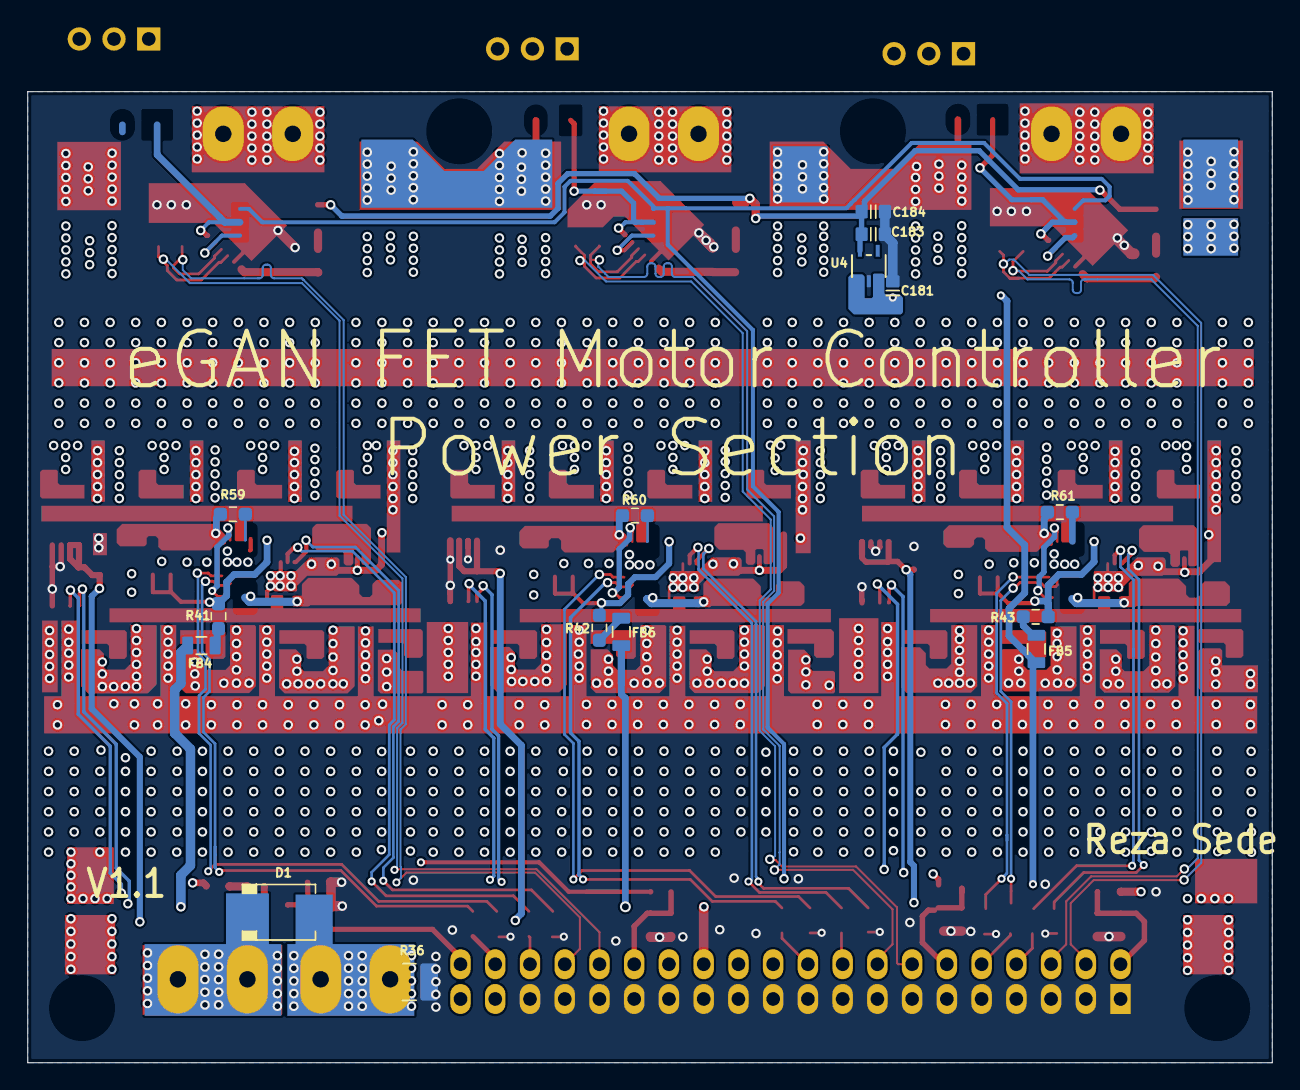
[picture p9: board MotorDrive_Power.kicad_pcb from below]

Board: 6 copper layers, 91.0 x 71.0 mm, 343 parts (15 on the bottom side), 104 nets.
