rezasede/AURIX_MotorControl_TB_HW/KicadControlAURIX/MotorDrive_Control_AURIX.kicad_pcb

## KiCad design KicadControlAURIX/MotorDrive_Control_AURIX.kicad_pcb (2026-04-05)

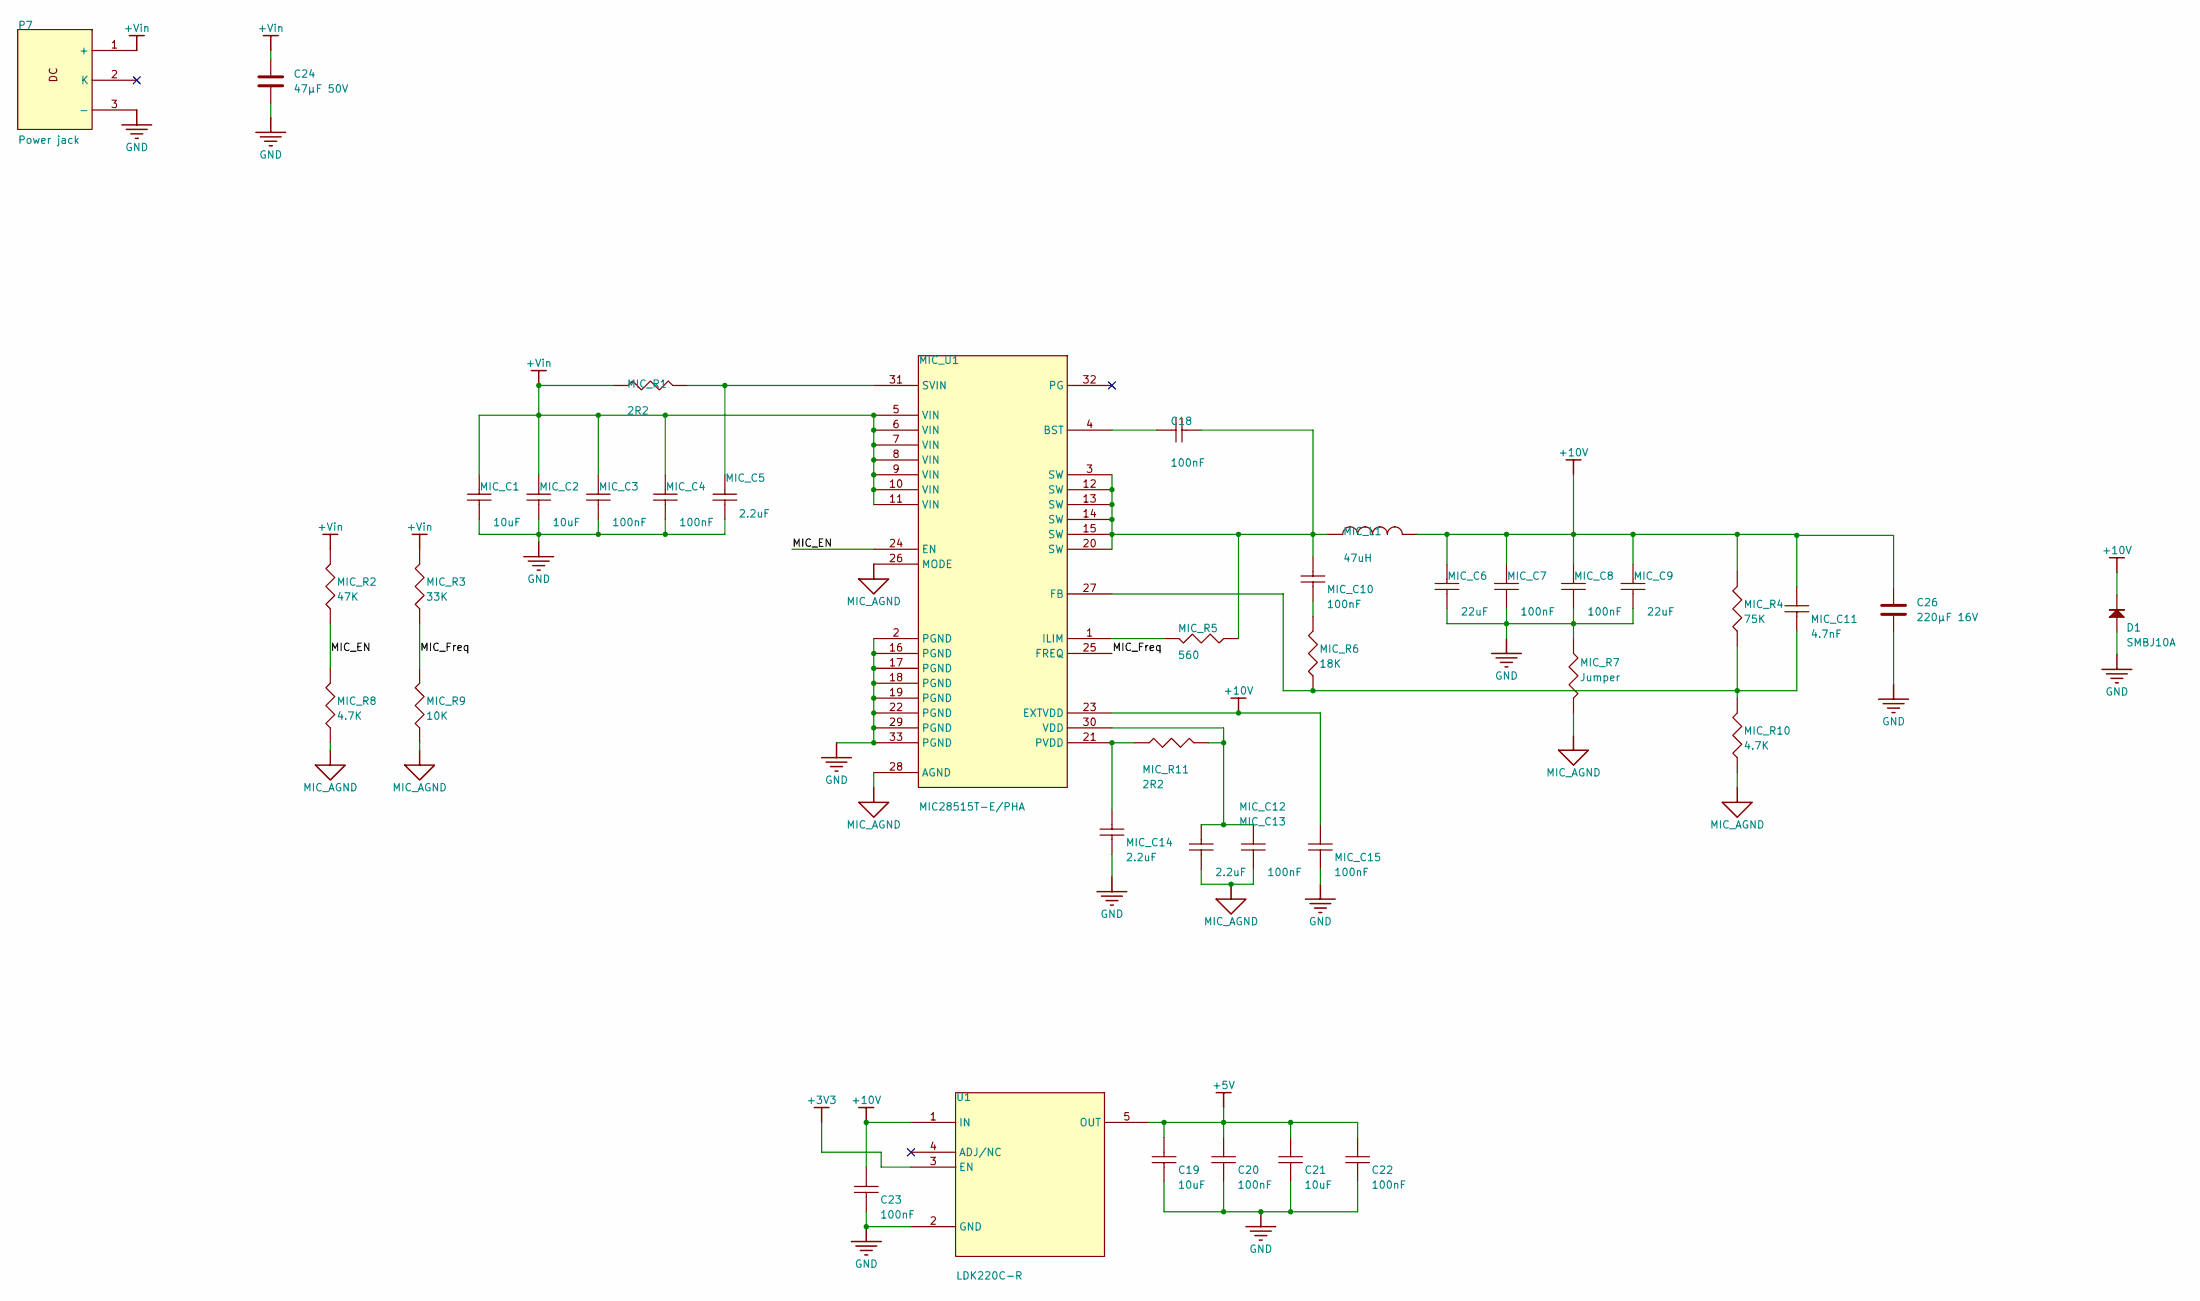
[picture p10: schematic PSU.kicad_sch]

Parts:
C18, C20, C22, C23: Cap SMD; CAPC1608X90N
C19, C21: Cap SMD; CAPC2012X135N
C24: 47µF 50V; C_Elec_6.3x7.7
C26: 220µF 16V; C_Elec_6.3x7.7
D1: SMBJ10A; DO-214AA
MIC_C1, MIC_C2, MIC_C5, MIC_C6, MIC_C9, MIC_C12, MIC_C14: Cap SMD; CAPC3216X100N
MIC_C3, MIC_C4, MIC_C13, MIC_C15: Cap SMD; CAPC2012X135N
MIC_C7, MIC_C8, MIC_C10, MIC_C11: Cap SMD; CAPC1608X90N
MIC_L1: Inductor; SCD503T-101K-N
MIC_R1, MIC_R2, MIC_R3, MIC_R4, MIC_R5, MIC_R6, MIC_R7, MIC_R8, MIC_R9, MIC_R10, MIC_R11: Res SMD; RESC1608X55N
MIC_U1: MIC28515T-E/PHA; VQFN32_PHA_MCH-M
P7: Power jack; power jaCK
U1: LDK220C-R; SOT_220M-R_STM; MANUFACTURER_PART_NUMBER LDK220C-R

Connections:
+3V3: U1.3 (EN); also elsewhere on the board
+5V: C19.2, C20.2, C21.2, C22.2, U1.5 (OUT); also elsewhere on the board
+10V: C23.2, C26.1, D1.K (2), MIC_C6.2, MIC_C7.2, MIC_C8.2, MIC_C9.2, MIC_C11.2, MIC_C15.2, MIC_L1.2, MIC_R4.2, MIC_U1.23 (EXTVDD), U1.1 (IN); also elsewhere on the board
+Vin: C24.1, MIC_C1.2, MIC_C2.2, MIC_C3.2, MIC_C4.2, MIC_R1.1, MIC_R2.2, MIC_R3.2, MIC_U1.5 (VIN), MIC_U1.6 (VIN), MIC_U1.7 (VIN), MIC_U1.8 (VIN), MIC_U1.9 (VIN), MIC_U1.10 (VIN), MIC_U1.11 (VIN), P7.1 (+); also elsewhere on the board
/U_PSU/MIC_EN: MIC_R2.1, MIC_R8.2, MIC_U1.24 (EN)
/U_PSU/MIC_Freq: MIC_R3.1, MIC_R9.2, MIC_U1.25 (FREQ)
GND: C19.1, C20.1, C21.1, C22.1, C23.1, C24.2, C26.2, D1.A (1), MIC_C1.1, MIC_C2.1, MIC_C3.1, MIC_C4.1, MIC_C5.2, MIC_C6.1, MIC_C7.1, MIC_C8.1, MIC_C9.1, MIC_C14.1, MIC_C15.1, MIC_R7.1, MIC_U1.2 (PGND), MIC_U1.16 (PGND), MIC_U1.17 (PGND), MIC_U1.18 (PGND), MIC_U1.19 (PGND), MIC_U1.22 (PGND), MIC_U1.29 (PGND), MIC_U1.33 (PGND), P7.3 (-), U1.2 (GND); also elsewhere on the board
MIC_AGND: MIC_C12.1, MIC_C13.1, MIC_R7.2, MIC_R8.1, MIC_R9.1, MIC_R10.1, MIC_U1.26 (MODE), MIC_U1.28 (AGND)
unnamed: C18.2, MIC_C10.2, MIC_L1.1, MIC_R5.1, MIC_U1.3 (SW), MIC_U1.12 (SW), MIC_U1.13 (SW), MIC_U1.14 (SW), MIC_U1.15 (SW), MIC_U1.20 (SW)
unnamed: MIC_C10.1, MIC_R6.2
unnamed: C18.1, MIC_U1.4 (BST)
unnamed: MIC_C11.1, MIC_R4.1, MIC_R6.1, MIC_R10.2, MIC_U1.27 (FB)
unnamed: MIC_R5.2, MIC_U1.1 (ILIM)
unnamed: MIC_C14.2, MIC_R11.1, MIC_U1.21 (PVDD)
unnamed: MIC_C5.1, MIC_R1.2, MIC_U1.31 (SVIN)
unnamed: MIC_C12.2, MIC_C13.2, MIC_R11.2, MIC_U1.30 (VDD)

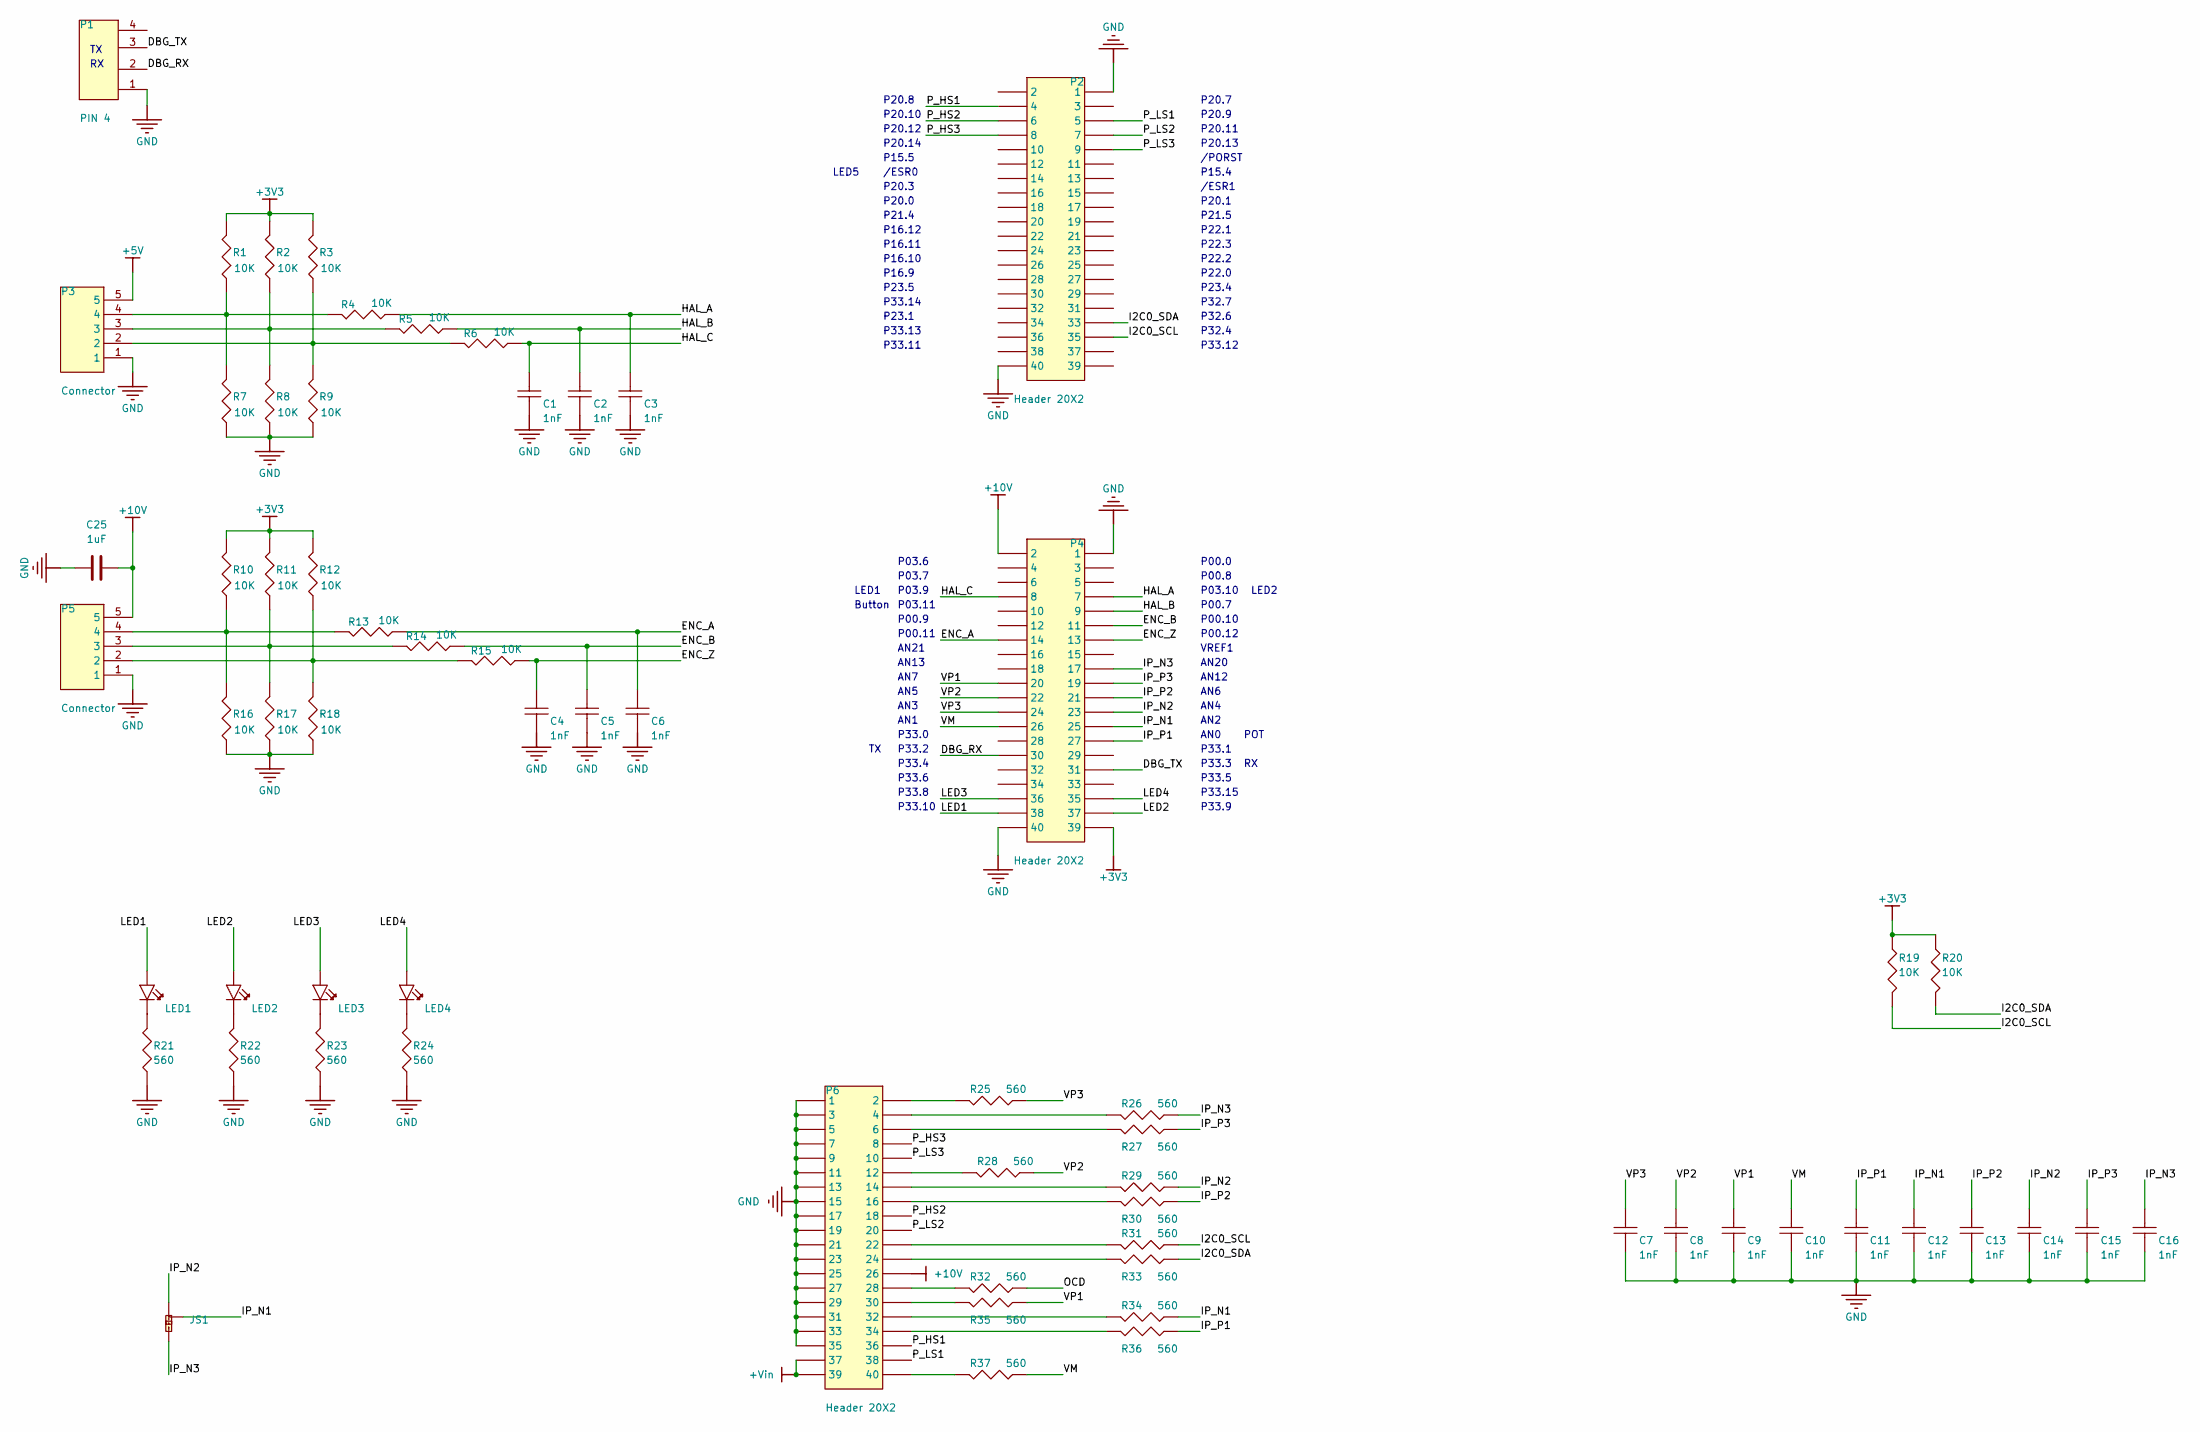
[picture p11: schematic Control.kicad_sch]

Parts:
C1, C2, C3, C4, C5, C6, C7, C8, C9, C10, C11, C12, C13, C14, C15, C16: Cap SMD; CAPC1608X90N
C25: 1uF; C_0805_2012Metric_Pad1.18x1.45mm_HandSolder
JS1: JumperSMD 3Pin; JumperSMD 3Pin - UltraSmall
LED1, LED2, LED3, LED4: LED; LED0603
P1: PIN 4; PIN F4
P2, P4: Header 20X2; HDR2X20-MU
P3, P5: Connector; PH Connector 5Pin
P6: Header 20X2; HDR2X20-MD
R1, R2, R3, R4, R5, R6, R7, R8, R9, R10, R11, R12, R13, R14, R15, R16, R17, R18, R19, R20, R21, R22, R23, R24, R25, R26, R27, R28, R29, R30, R31, R32, R33, R34, R35, R36, R37: Res SMD; RESC1608X55N

Connections:
+3V3: P4.39, R1.2, R2.2, R3.2, R10.2, R11.2, R12.2, R19.1, R20.1; also elsewhere on the board
+5V: P3.5; also elsewhere on the board
+10V: C25.2, P4.2, P5.5, P6.26; also elsewhere on the board
+Vin: P6.37, P6.39; also elsewhere on the board
/U_Control/DBG_RX: P1.2, P4.30
/U_Control/DBG_TX: P1.3, P4.31
/U_Control/ENC_A: C6.2, P4.14, R13.1
/U_Control/ENC_B: C5.2, P4.11, R14.1
/U_Control/ENC_Z: C4.2, P4.13, R15.1
/U_Control/HAL_A: C3.2, P4.7, R4.1
/U_Control/HAL_B: C2.2, P4.9, R5.1
/U_Control/HAL_C: C1.2, P4.8, R6.1
/U_Control/I2C0_SCL: P2.35, R19.2, R31.1
/U_Control/I2C0_SDA: P2.33, R20.2, R33.1
/U_Control/IP_N1: C12.2, JS1.2, P4.25, R34.1
/U_Control/IP_N2: C14.2, JS1.1, P4.23, R29.1
/U_Control/IP_N3: C16.2, JS1.3, P4.17, R26.1
/U_Control/IP_P1: C11.2, P4.27, R36.1
/U_Control/IP_P2: C13.2, P4.21, R30.1
/U_Control/IP_P3: C15.2, P4.19, R27.1
/U_Control/LED1: LED1.1 (A), P4.38
/U_Control/LED2: LED2.1 (A), P4.37
/U_Control/LED3: LED3.1 (A), P4.36
/U_Control/LED4: LED4.1 (A), P4.35
/U_Control/OCD: R32.1
/U_Control/P_HS1: P2.4, P6.36
/U_Control/P_HS2: P2.6, P6.18
/U_Control/P_HS3: P2.8, P6.8
/U_Control/P_LS1: P2.5, P6.38
/U_Control/P_LS2: P2.7, P6.20
/U_Control/P_LS3: P2.9, P6.10
/U_Control/VM: C10.2, P4.26, R37.1
/U_Control/VP1: C9.2, P4.20, R35.1
/U_Control/VP2: C8.2, P4.22, R28.1
/U_Control/VP3: C7.2, P4.24, R25.1
GND: C1.1, C2.1, C3.1, C4.1, C5.1, C6.1, C7.1, C8.1, C9.1, C10.1, C11.1, C12.1, C13.1, C14.1, C15.1, C16.1, C25.1, P1.1, P2.1, P2.40, P3.1, P4.1, P4.40, P5.1, P6.1, P6.3, P6.5, P6.7, P6.9, P6.11, P6.13, P6.15, P6.17, P6.19, P6.21, P6.23, P6.25, P6.27, P6.29, P6.31, P6.33, P6.35, R7.1, R8.1, R9.1, R16.1, R17.1, R18.1, R21.1, R22.1, R23.1, R24.1; also elsewhere on the board
unnamed: LED1.2 (K), R21.2
unnamed: LED2.2 (K), R22.2
unnamed: LED3.2 (K), R23.2
unnamed: LED4.2 (K), R24.2
unnamed: P3.2, R3.1, R6.2, R9.2
unnamed: P3.3, R2.1, R5.2, R8.2
unnamed: P3.4, R1.1, R4.2, R7.2
unnamed: P5.2, R12.1, R15.2, R18.2
unnamed: P5.3, R11.1, R14.2, R17.2
unnamed: P5.4, R10.1, R13.2, R16.2
unnamed: P6.2, R25.2
unnamed: P6.4, R26.2
unnamed: P6.6, R27.2
unnamed: P6.12, R28.2
unnamed: P6.14, R29.2
unnamed: P6.16, R30.2
unnamed: P6.22, R31.2
unnamed: P6.24, R33.2
unnamed: P6.28, R32.2
unnamed: P6.30, R35.2
unnamed: P6.32, R34.2
unnamed: P6.34, R36.2
unnamed: P6.40, R37.2

Notes on the sheet:
P00.11
AN0
P20.0
/PORST
LED5
P00.9
P15.4
P16.10
P16.11
LED2
P33.9
AN6
P33.2
P20.9
AN13
P33.12
P20.11
P20.12
P23.1
P33.1
P22.2
P00.10
Button
P00.7
P33.14
P16.9
AN1
P21.5
P23.4
VREF1
P33.0
P33.8
P33.15
P03.10
P00.12
AN21
P03.6
POT
P00.0
AN20
P33.4
P33.6
P03.7
P03.9
P20.3
/ESR0
P03.11
AN4
P20.14
AN5
P20.13
P20.1
AN3
AN7
P15.5
P22.3
P20.7
LED1
P32.6
P33.3
P33.11
P00.8
P22.0
P32.4
P33.5
P20.8
P32.7
P16.12
AN12
P22.1
/ESR1
P23.5
P21.4
AN2
P20.10
P33.10
P33.13

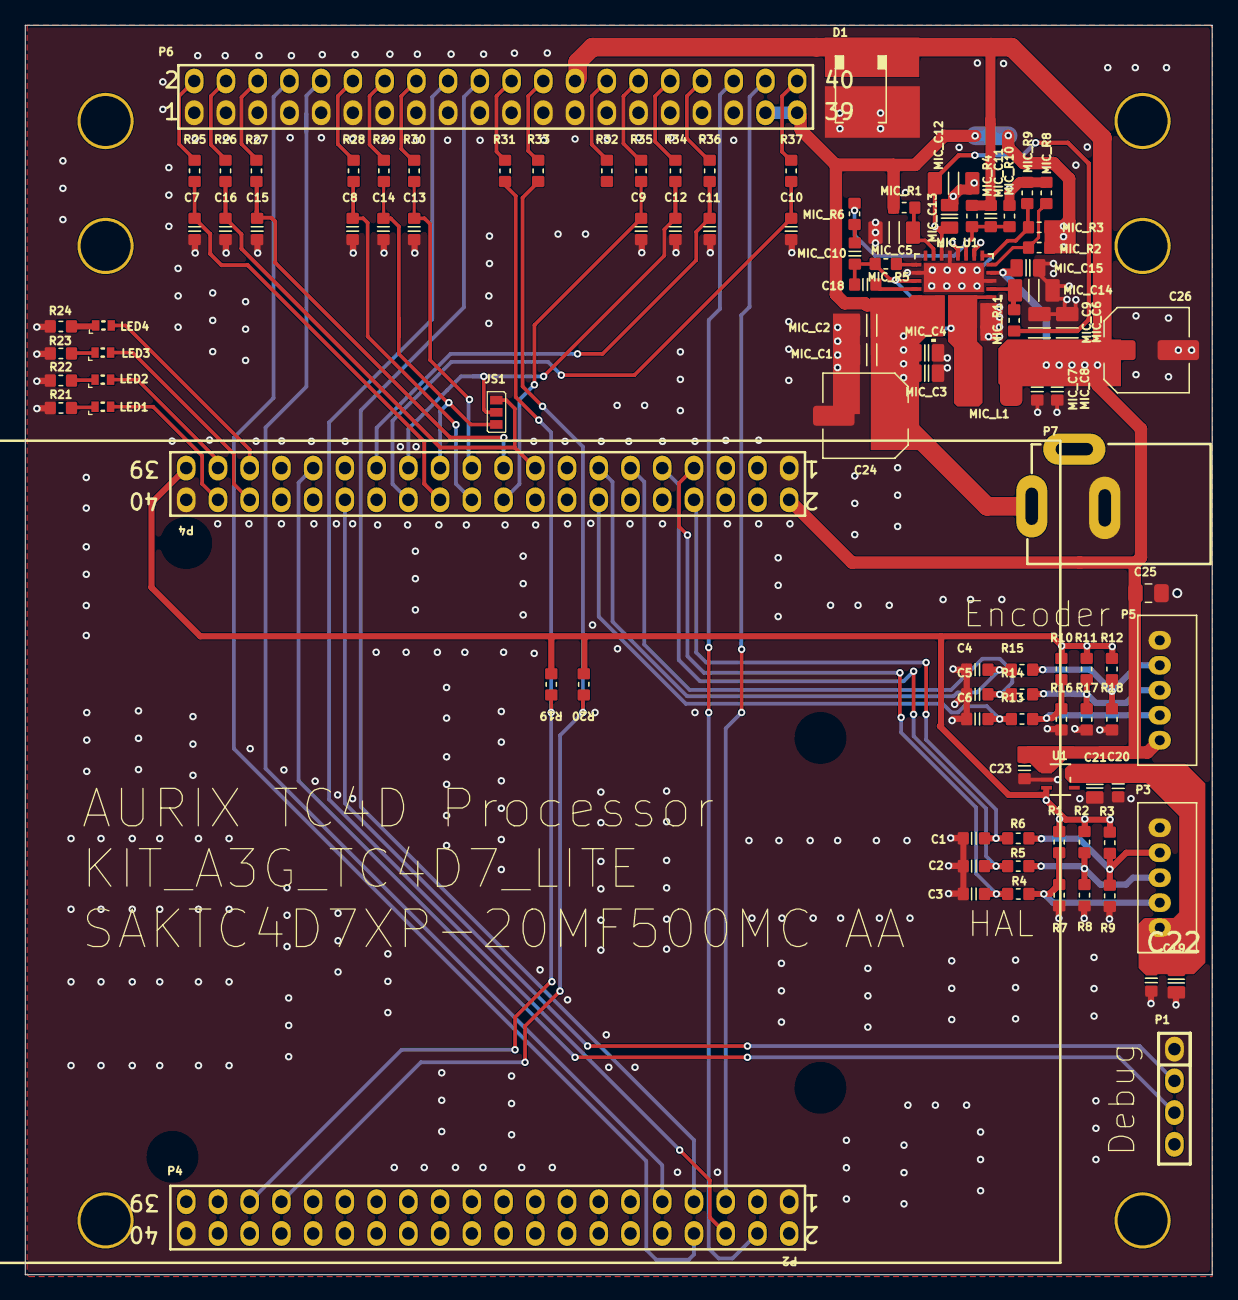
[picture p12: board MotorDrive_Control_AURIX.kicad_pcb from above]

Board: 2 copper layers, 95.0 x 100.0 mm, 104 parts (1 on the bottom side), 69 nets.
