rezasede/AURIX_MotorControl_TB_HW/(commit log)

2026-04-02 successful migration and fixing in kicad
    [Bulk_Caps.kicad_sch, Connector.kicad_sch, GateDrive.kicad_sch, MotorDrive_Power.csv, MotorDrive_Power.kicad_pcb, MotorDrive_Power.kicad_sch, PowerStage.kicad_sch, Sensing.kicad_sch]
2026-04-02 minor changes
    [Connector.kicad_sch, GateDrive.kicad_sch, MotorDrive_Power.kicad_pcb, MotorDrive_Power.kicad_sch, PowerStage.kicad_sch, Sensing.kicad_sch, TempSensor.kicad_sch]
2026-04-03 new G serie of Driver modifed and finished
    [Bulk_Caps.kicad_sch, GateDrive.kicad_sch, MotorDrive_Power.kicad_pcb]
2026-04-05 Sent for Manufacturing V1.0
    [MotorDrive_Control_AURIX.kicad_pcb, MotorDrive_Power.kicad_pcb]
2026-10-25 readme added and few fixing in schematic and PCB
    [Connector.kicad_sch, GateDrive.kicad_sch, MotorDrive_Power.kicad_pcb, MotorDrive_Power.kicad_sch, Sensing.kicad_sch, TempSensor.kicad_sch]
