rezasede/AURIX_MotorControl_TB_HW/(notices)

Notices in the files:
parts and their libraries:
COPYRIGHT: Copyright (C) 2025 Ultra Librarian. All rights reserved.
COPYRIGHT: Copyright (C) 2026 Ultra Librarian. All rights reserved.
